AndyEveritt/FEEG2001-Eurobot/README.md

# Eurobot 2017

University of Southampton Eurobot 2017
