AndyEveritt/FEEG2001-Eurobot/CAD/Launcher/preview.JPG

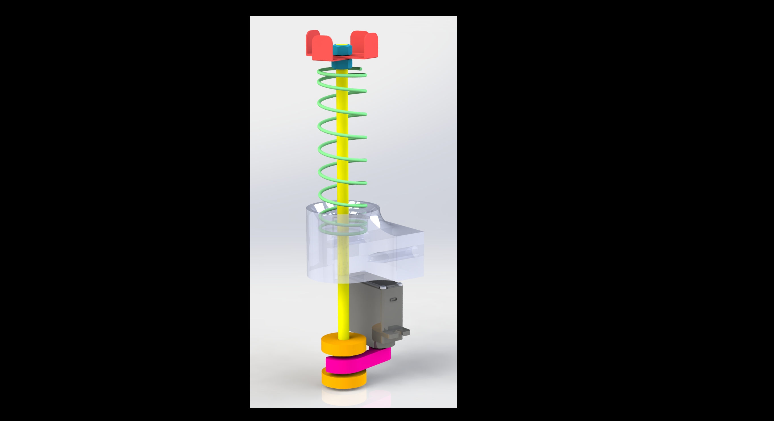
CAD/Launcher/preview.JPG
