AndyEveritt/FEEG2001-Eurobot/Code/Demonstration Route.png

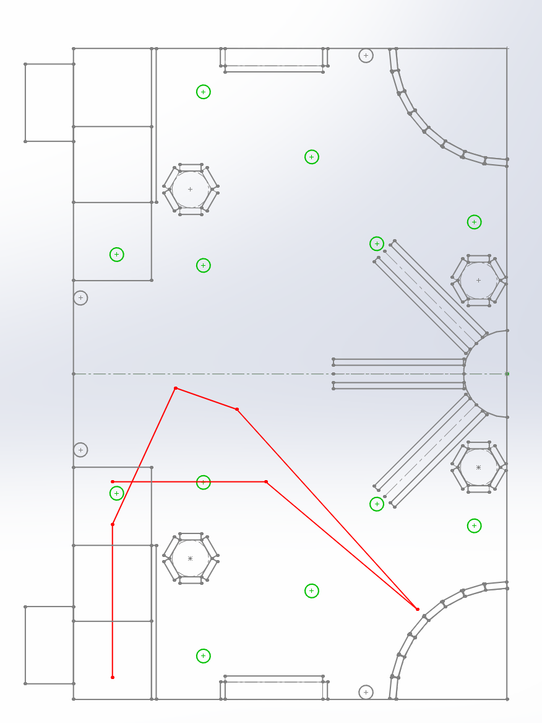
Code/Demonstration Route.png
