AndyEveritt/FEEG2001-Eurobot/Code/Screen Shot 2017-03-15 at 10.18.48.png

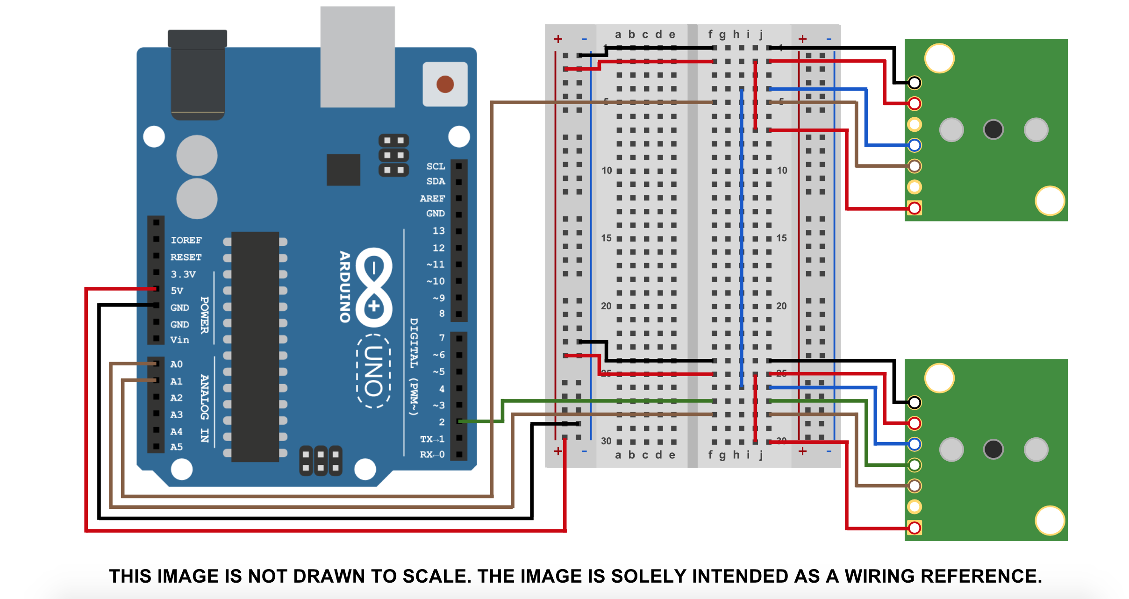
Code/Screen Shot 2017-03-15 at 10.18.48.png
