AndyEveritt/FEEG2001-Eurobot/Code/Speed Profile.png

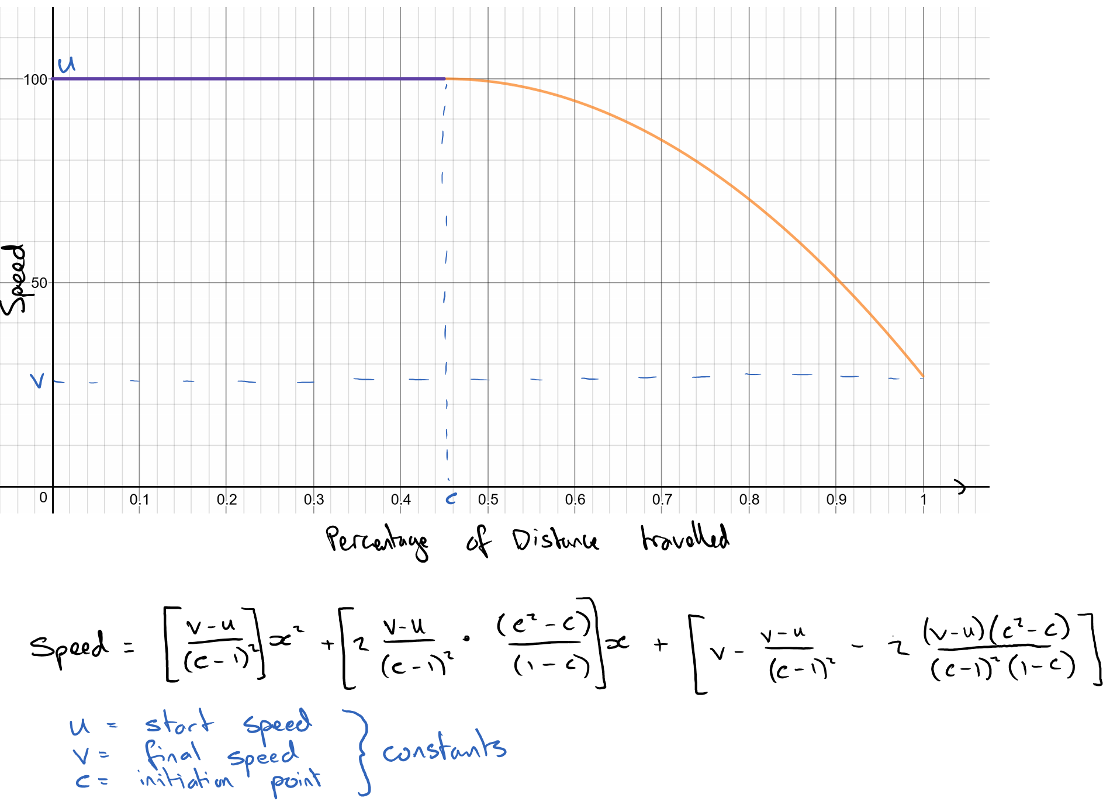
Code/Speed Profile.png
