AndyEveritt/FEEG2001-Eurobot/Concept Design Report/overallsketch2.jpeg

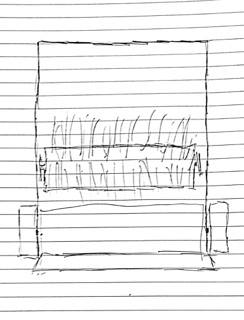
Concept Design Report/overallsketch2.jpeg
