AndyEveritt/FEEG2001-Eurobot/Concept Design Report/overallsketch 3.jpeg

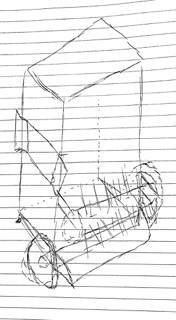
Concept Design Report/overallsketch 3.jpeg
