AndyEveritt/FEEG2001-Eurobot/CAD/RobotV2/RobotV2.SLDASM

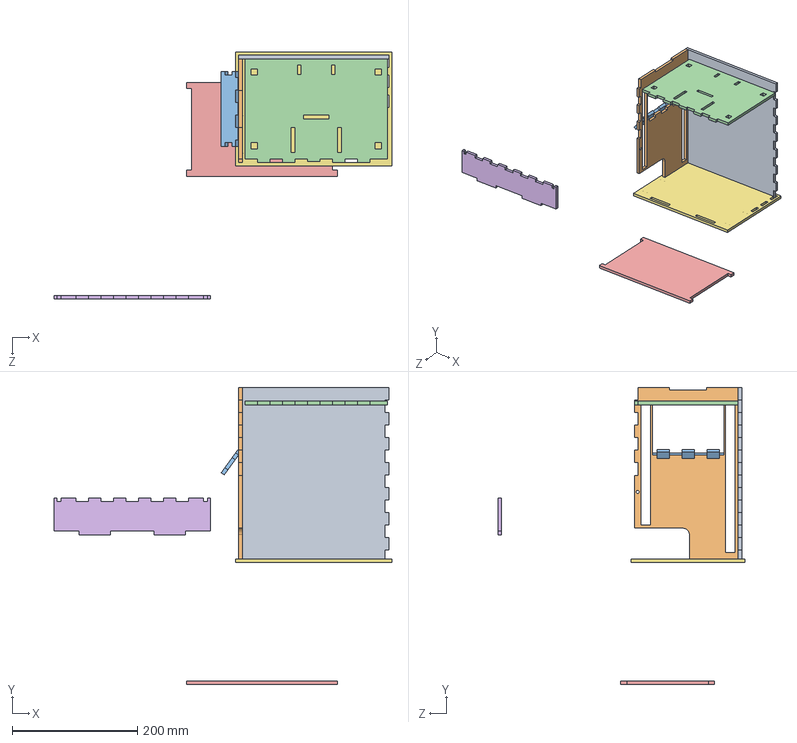
[picture p7: CAD file, 2020-12-26]
CAD/RobotV2/RobotV2.SLDASM
540.0 x 474.9 x 394.8 mm
BackV2
Lift System - Side
Lift System - Top Ramp Shortened
Lift System - TopShortened
Lift System - Tray Base Shortened
LoweredFront
Base
