AndyEveritt/FEEG2001-Eurobot/CAD/Base/BaseWheelsElliot.SLDASM

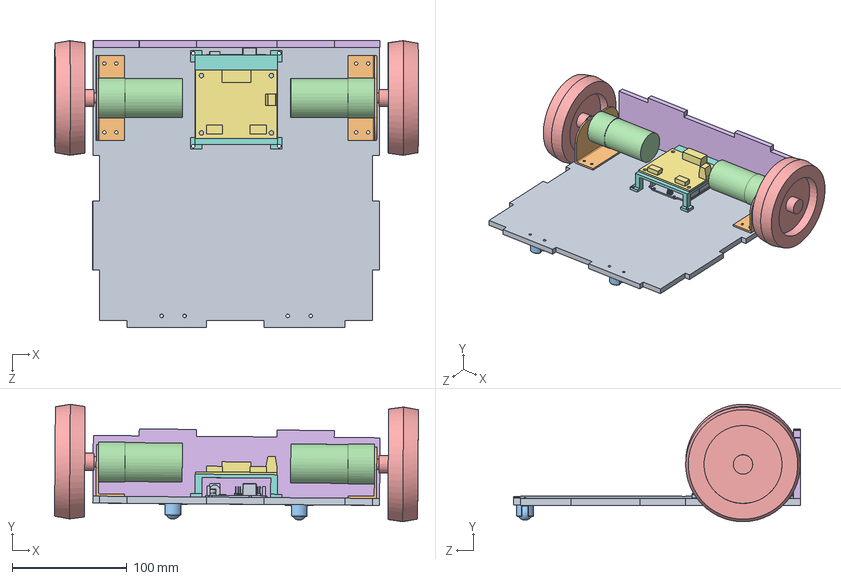
[picture p8: CAD file, 2020-12-26]
CAD/Base/BaseWheelsElliot.SLDASM
317.3 x 102.3 x 250.0 mm
Base
Motor Mount x 2
Ball Caster x 2
Motor x 2
Wheel x 2
Front
MD25
Table
Arduino UNO
