AndyEveritt/FEEG2001-Eurobot/CAD/HS-82MG Servo/HS-82MG (Micro Server).SLDASM

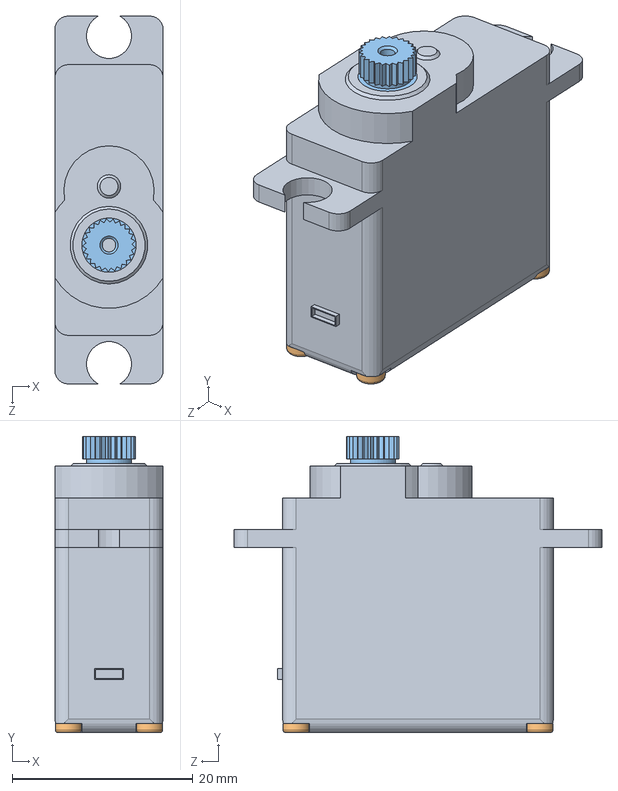
[picture p9: CAD file, 2020-12-26]
CAD/HS-82MG Servo/HS-82MG (Micro Server).SLDASM
12.0 x 32.8 x 40.8 mm
Servo Body
screw head x 4
Metal Gear
