AndyEveritt/FEEG2001-Eurobot/CAD/Launcher/Launcher.SLDASM

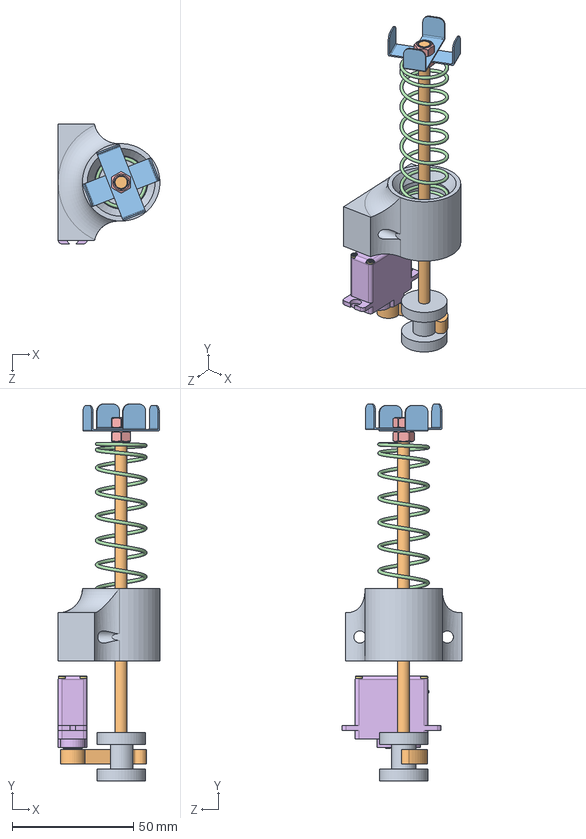
[picture p11: CAD file, 2020-12-26]
CAD/Launcher/Launcher.SLDASM
42.0 x 155.5 x 49.4 mm
Spring Holder
Rod
Holder x 2
Spring
universal_nut x 2
Servo Body
screw head x 4
Metal Gear
Latch 2
Latch 2 Hook
