AndyEveritt/FEEG2001-Eurobot/CAD/3D Printing/Spring Holder.STL

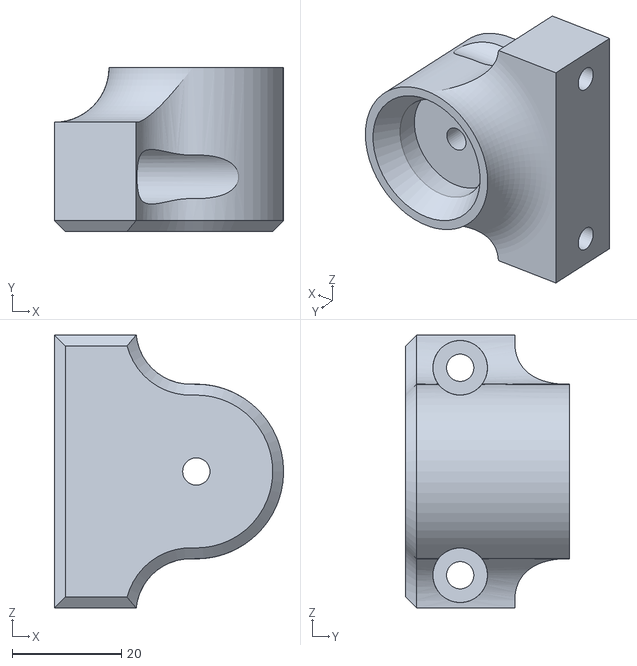
[picture p12: CAD file, 2020-12-26]
CAD/3D Printing/Spring Holder.STL
42.0 x 30.0 x 50.0
