AndyEveritt/FEEG2001-Eurobot/CAD/Base/Drawings/Front.DXF

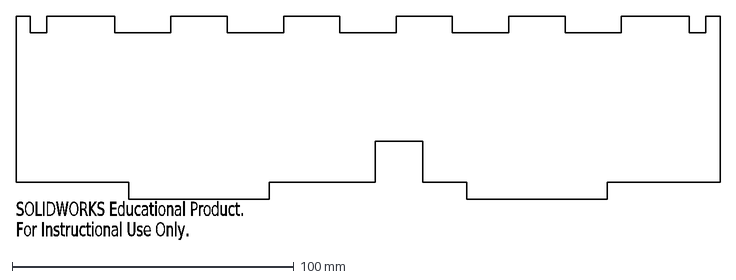
[picture p13: CAD file, 2020-12-26]
CAD/Base/Drawings/Front.DXF
SOLIDWORKS Educational Product.
For Instructional Use Only.
