AndyEveritt/FEEG2001-Eurobot/CAD/Base/Side.SLDPRT

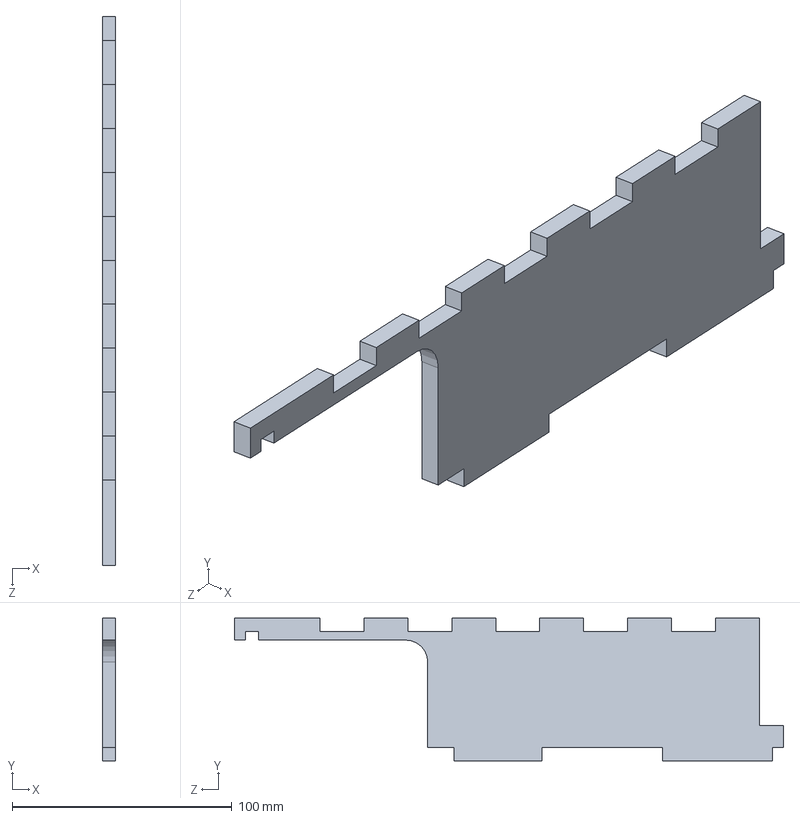
[picture p14: CAD file, 2020-12-26]
CAD/Base/Side.SLDPRT
6.00 x 65.0 x 250.0 mm
