AndyEveritt/FEEG2001-Eurobot/CAD/Existing Parts/Battery.SLDPRT

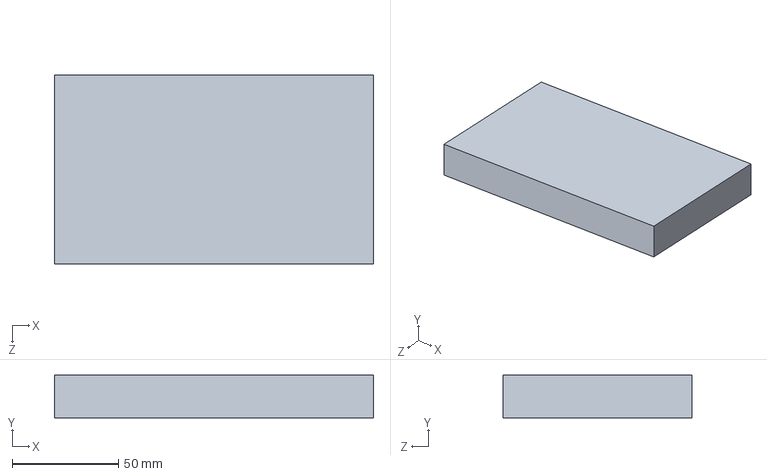
[picture p15: CAD file, 2020-12-26]
CAD/Existing Parts/Battery.SLDPRT
150.0 x 20.0 x 89.0 mm
