AndyEveritt/FEEG2001-Eurobot/CAD/PullCord.SLDPRT

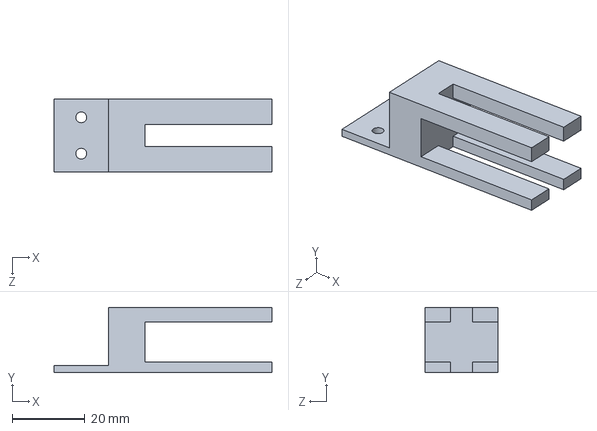
[picture p16: CAD file, 2020-12-26]
CAD/PullCord.SLDPRT
60.0 x 18.0 x 20.0 mm
