AndyEveritt/FEEG2001-Eurobot/CAD/RobotV2/Drawings/Lift System - TopShortened.DXF

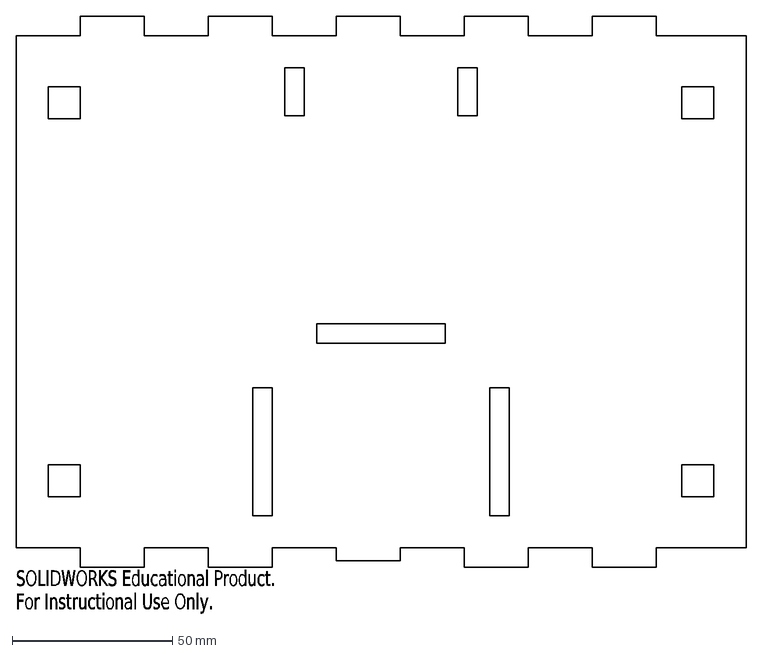
[picture p17: CAD file, 2020-12-26]
CAD/RobotV2/Drawings/Lift System - TopShortened.DXF
SOLIDWORKS Educational Product.
For Instructional Use Only.
