AndyEveritt/FEEG2001-Eurobot/CAD/3D Printing/Table.STL

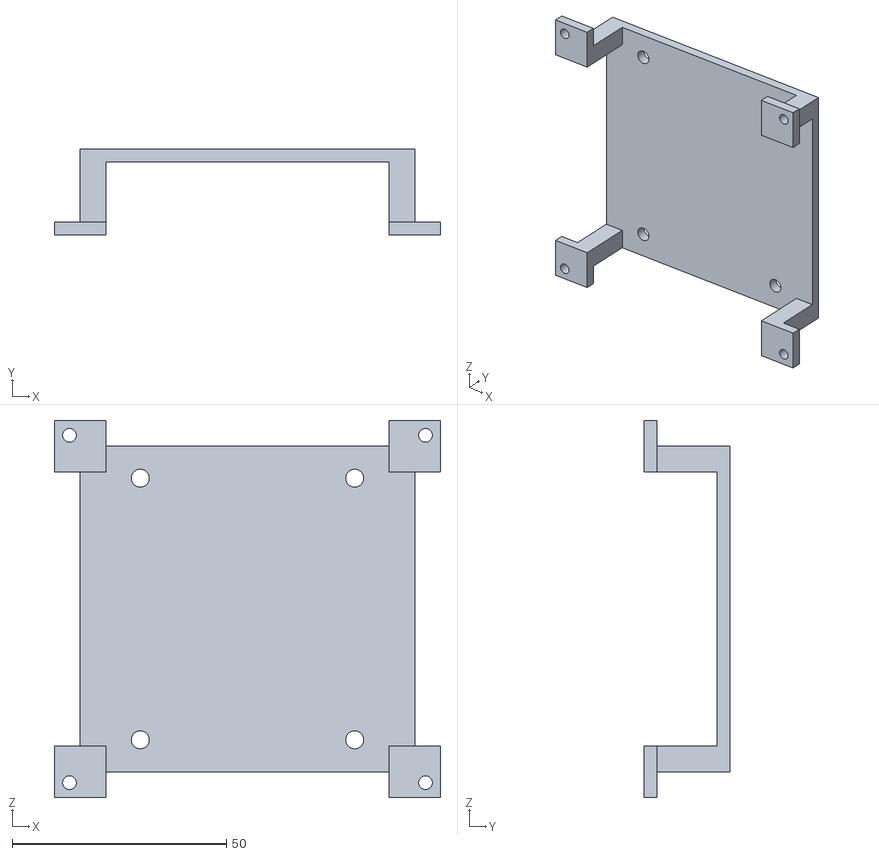
[picture p18: CAD file, 2020-12-26]
CAD/3D Printing/Table.STL
90.0 x 20.0 x 88.0
