AndyEveritt/FEEG2001-Eurobot/CAD/Base/Back.SLDPRT

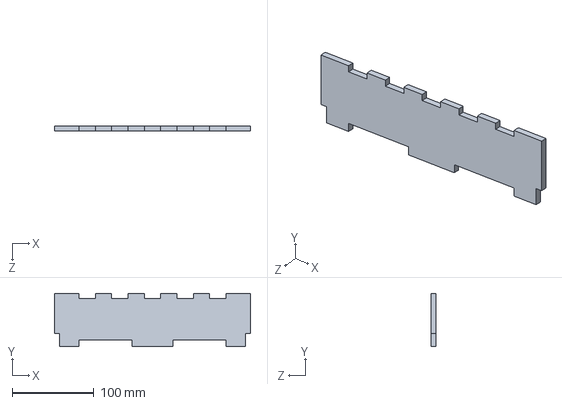
[picture p19: CAD file, 2020-12-26]
CAD/Base/Back.SLDPRT
240.0 x 65.0 x 6.00 mm
