AndyEveritt/FEEG2001-Eurobot/CAD/Base/Drawings/Back (flat).DXF

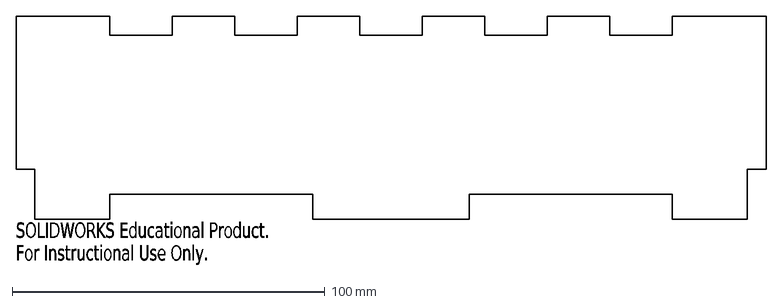
[picture p20: CAD file, 2020-12-26]
CAD/Base/Drawings/Back (flat).DXF
SOLIDWORKS Educational Product.
For Instructional Use Only.
