AndyEveritt/FEEG2001-Eurobot/CAD/Existing Parts/Motor.SLDPRT

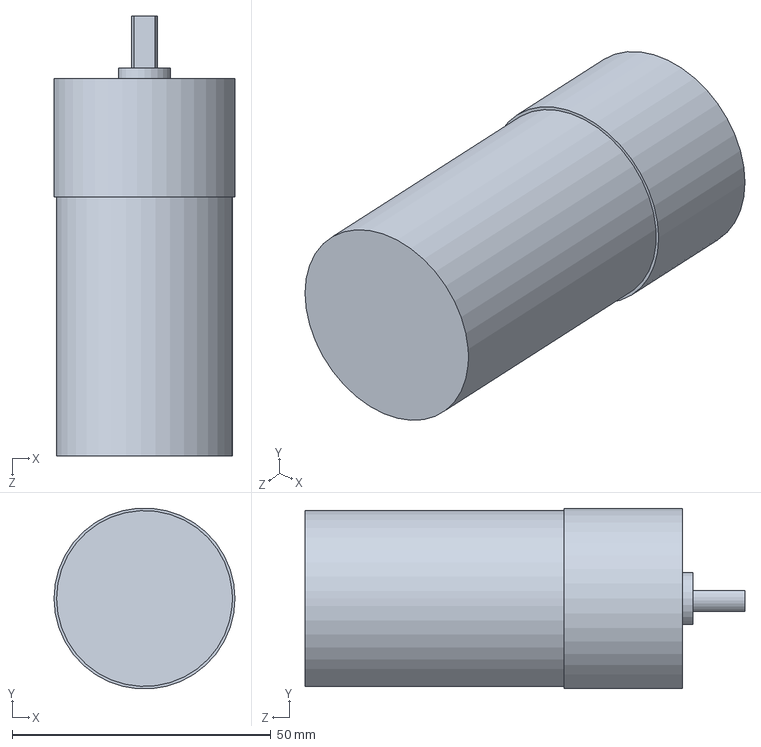
[picture p21: CAD file, 2020-12-26]
CAD/Existing Parts/Motor.SLDPRT
35.0 x 34.9 x 85.0 mm
