AndyEveritt/FEEG2001-Eurobot/CAD/HS-82MG Servo/Servo Body.SLDPRT

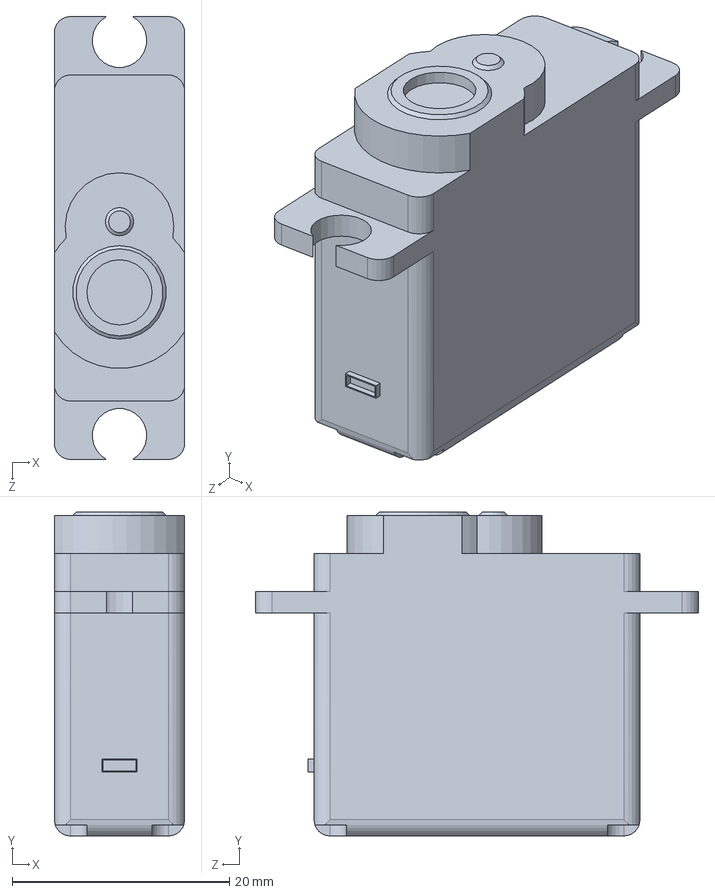
[picture p22: CAD file, 2020-12-26]
CAD/HS-82MG Servo/Servo Body.SLDPRT
12.0 x 29.8 x 40.8 mm
