AndyEveritt/FEEG2001-Eurobot/CAD/Launcher/Holder.SLDPRT

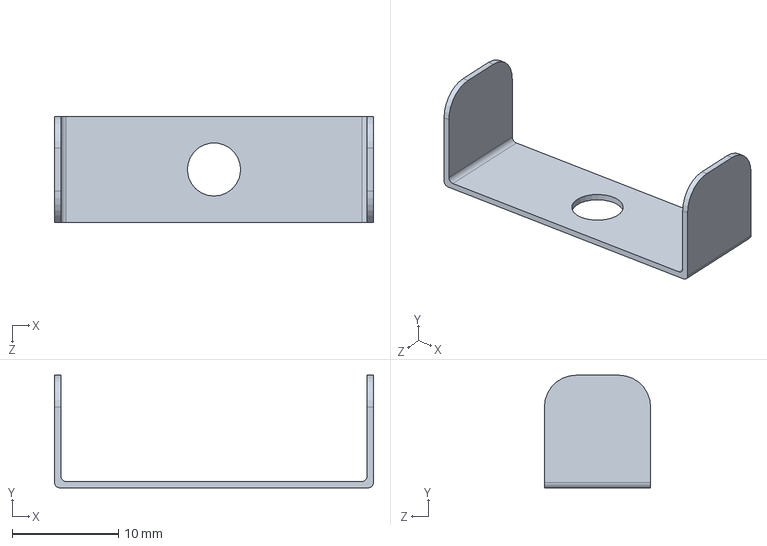
[picture p23: CAD file, 2020-12-26]
CAD/Launcher/Holder.SLDPRT
30.0 x 10.6 x 10.0 mm
