AndyEveritt/FEEG2001-Eurobot/CAD/RobotV2/Drawings/LoweredFront.DXF

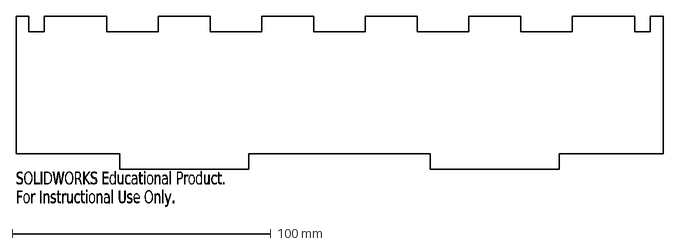
[picture p24: CAD file, 2020-12-26]
CAD/RobotV2/Drawings/LoweredFront.DXF
SOLIDWORKS Educational Product.
For Instructional Use Only.
