AndyEveritt/FEEG2001-Eurobot/CAD/RobotV2/Lift System - Tray Base Shortened.SLDPRT

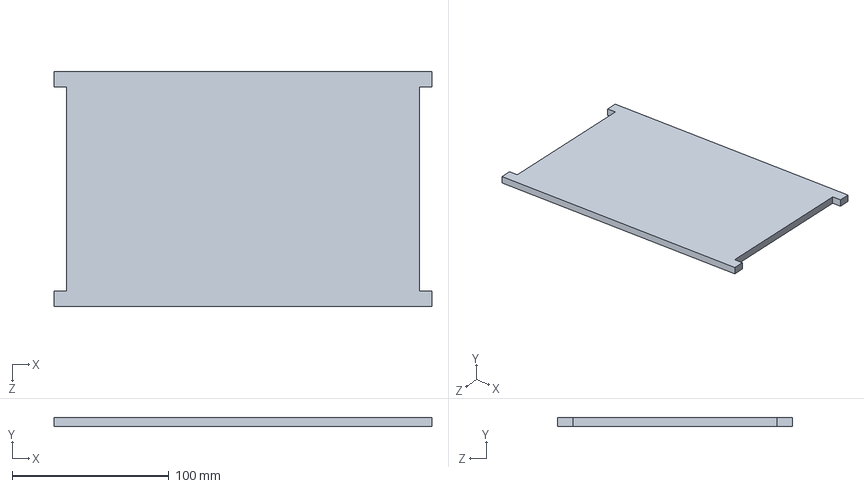
[picture p25: CAD file, 2020-12-26]
CAD/RobotV2/Lift System - Tray Base Shortened.SLDPRT
241.0 x 6.00 x 150.0 mm
