AndyEveritt/FEEG2001-Eurobot/CAD/Base/Drawings/Side (flat).DXF

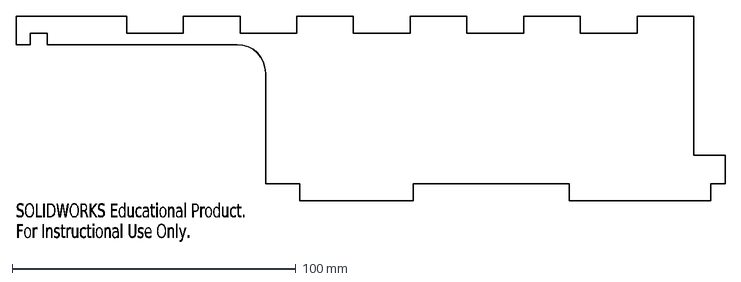
[picture p26: CAD file, 2020-12-26]
CAD/Base/Drawings/Side (flat).DXF
SOLIDWORKS Educational Product.
For Instructional Use Only.
