AndyEveritt/FEEG2001-Eurobot/CAD/Existing Parts/Wheel.SLDPRT

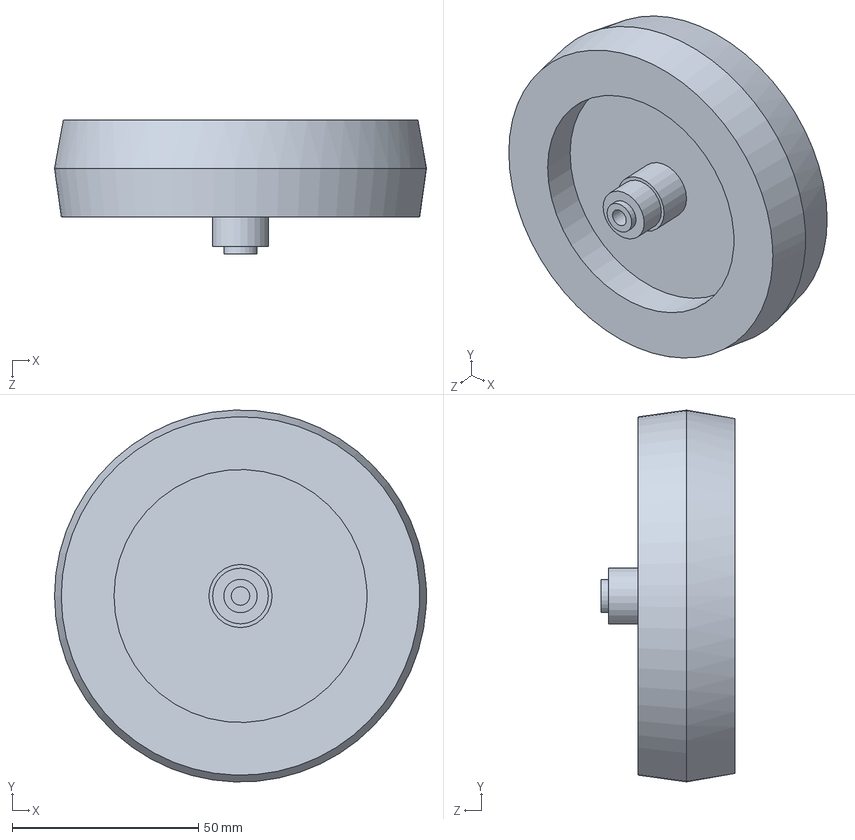
[picture p27: CAD file, 2020-12-26]
CAD/Existing Parts/Wheel.SLDPRT
100.0 x 100.0 x 36.0 mm
