AndyEveritt/FEEG2001-Eurobot/CAD/Launcher/Latch.SLDPRT

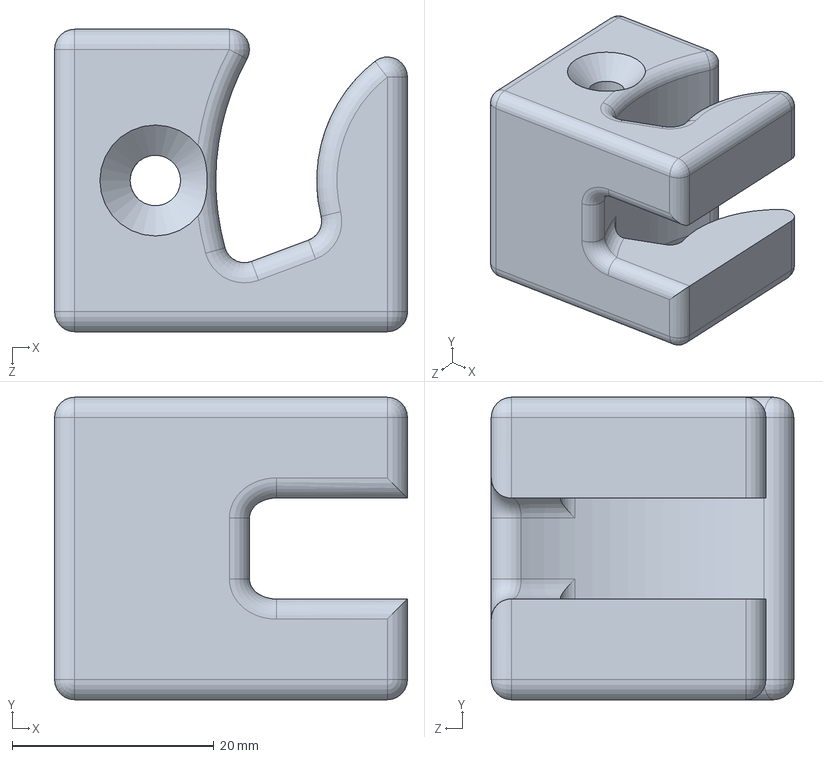
[picture p28: CAD file, 2020-12-26]
CAD/Launcher/Latch.SLDPRT
35.0 x 30.0 x 30.0 mm
