AndyEveritt/FEEG2001-Eurobot/CAD/RobotV2/Drawings/Base.DXF

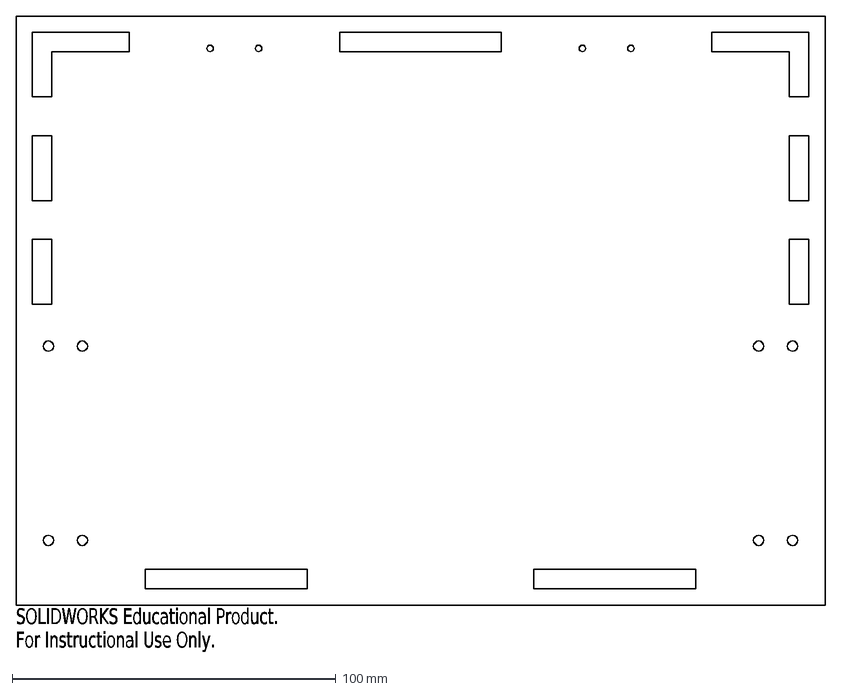
[picture p29: CAD file, 2020-12-26]
CAD/RobotV2/Drawings/Base.DXF
SOLIDWORKS Educational Product.
For Instructional Use Only.
