AndyEveritt/FEEG2001-Eurobot/CAD/RobotV2/Lift System - Top Ramp Shortened.SLDPRT

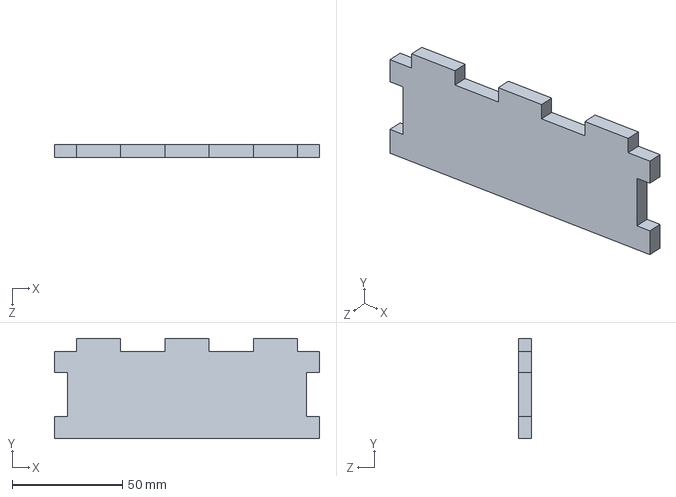
[picture p30: CAD file, 2020-12-26]
CAD/RobotV2/Lift System - Top Ramp Shortened.SLDPRT
120.0 x 45.3 x 6.00 mm
