AndyEveritt/FEEG2001-Eurobot/CAD/Base/Base.SLDPRT

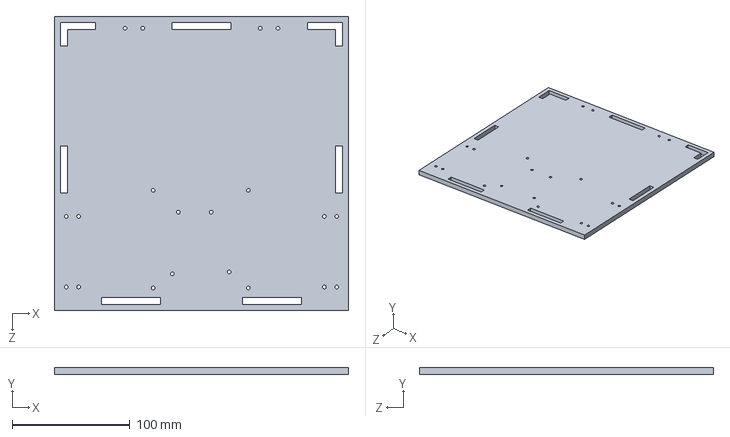
[picture p31: CAD file, 2020-12-26]
CAD/Base/Base.SLDPRT
250.0 x 6.00 x 250.0 mm
