AndyEveritt/FEEG2001-Eurobot/CAD/Base/Drawings/Back.DXF

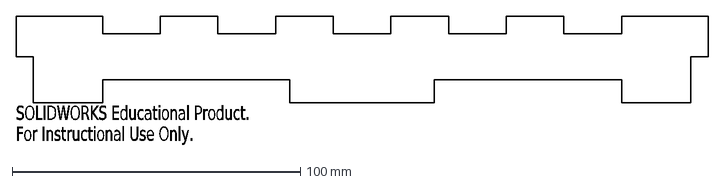
[picture p32: CAD file, 2020-12-26]
CAD/Base/Drawings/Back.DXF
SOLIDWORKS Educational Product.
For Instructional Use Only.
