AndyEveritt/FEEG2001-Eurobot/CAD/Existing Parts/Motor Mount.SLDPRT

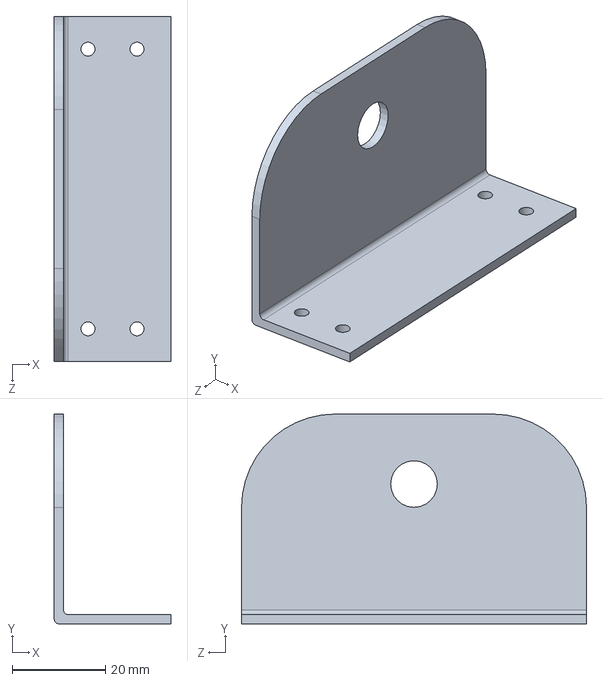
[picture p33: CAD file, 2020-12-26]
CAD/Existing Parts/Motor Mount.SLDPRT
25.0 x 45.0 x 74.0 mm
