AndyEveritt/FEEG2001-Eurobot/CAD/HS-82MG Servo/Metal Gear.SLDPRT

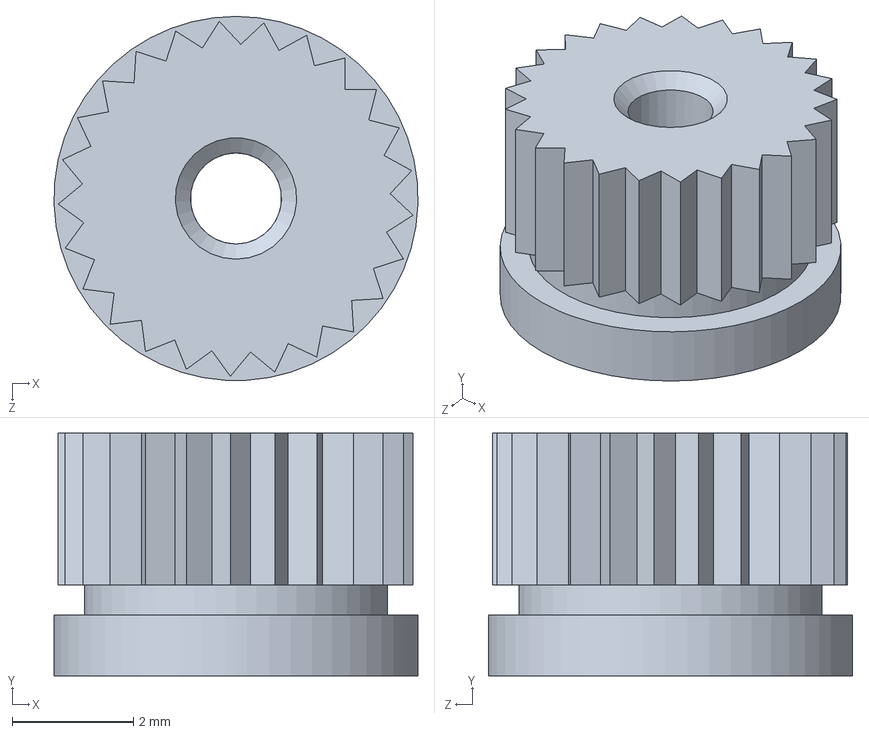
[picture p34: CAD file, 2020-12-26]
CAD/HS-82MG Servo/Metal Gear.SLDPRT
6.00 x 4.00 x 6.00 mm
