AndyEveritt/FEEG2001-Eurobot/CAD/Launcher/Latch 2 Hook.SLDPRT

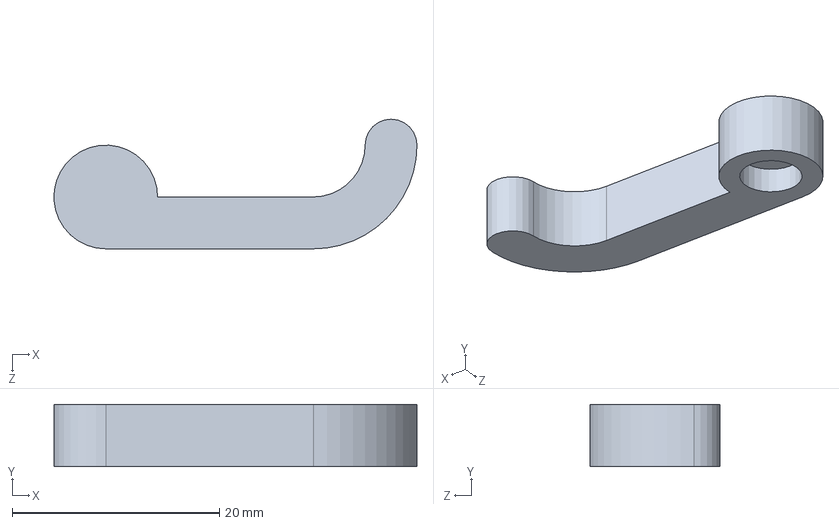
[picture p35: CAD file, 2020-12-26]
CAD/Launcher/Latch 2 Hook.SLDPRT
35.0 x 6.00 x 12.5 mm
