AndyEveritt/FEEG2001-Eurobot/CAD/RobotV2/Base.SLDPRT

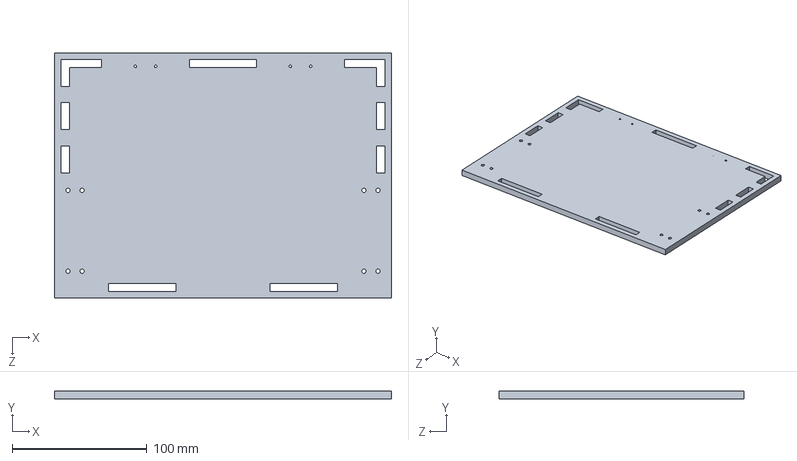
[picture p36: CAD file, 2020-12-26]
CAD/RobotV2/Base.SLDPRT
250.0 x 6.00 x 182.0 mm
