AndyEveritt/FEEG2001-Eurobot/CAD/RobotV2/Drawings/BackV2.DXF

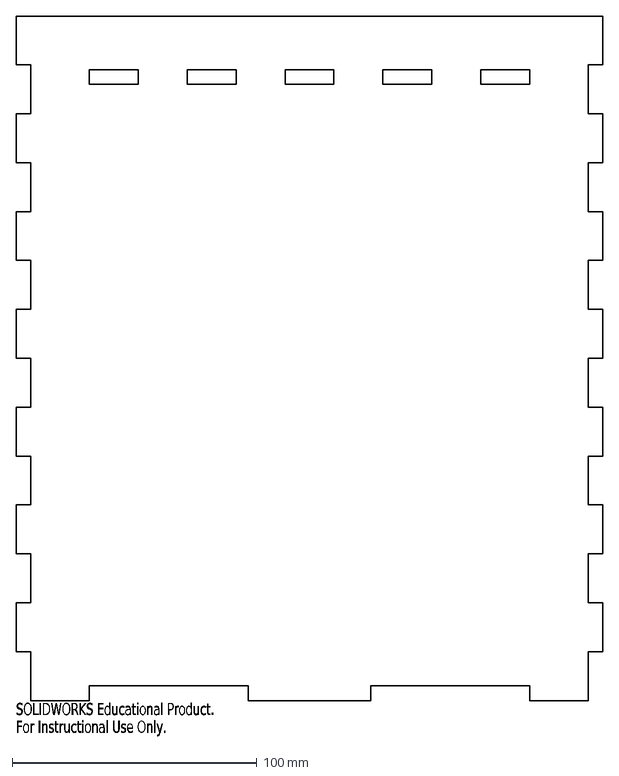
[picture p37: CAD file, 2020-12-26]
CAD/RobotV2/Drawings/BackV2.DXF
SOLIDWORKS Educational Product.
For Instructional Use Only.
