AndyEveritt/FEEG2001-Eurobot/CAD/Base/Arduino UNO.SLDPRT

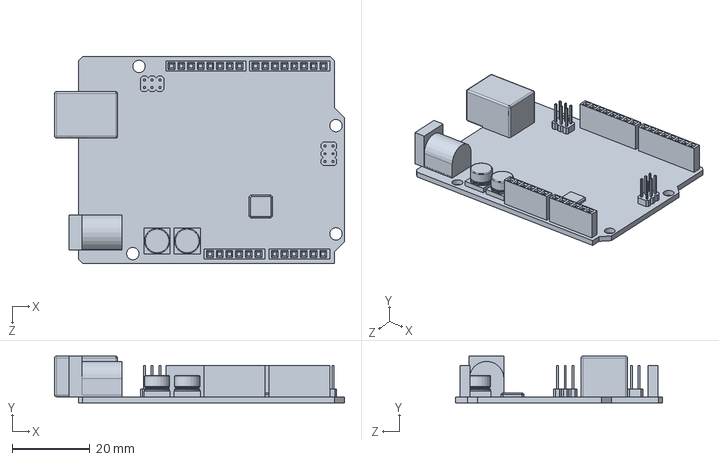
[picture p38: CAD file, 2020-12-26]
CAD/Base/Arduino UNO.SLDPRT
74.8 x 12.1 x 53.3 mm
