AndyEveritt/FEEG2001-Eurobot/CAD/Base/Drawings/Side.DXF

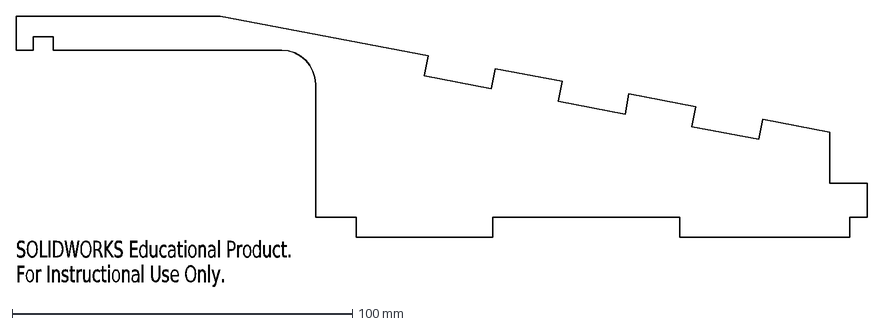
[picture p39: CAD file, 2020-12-26]
CAD/Base/Drawings/Side.DXF
SOLIDWORKS Educational Product.
For Instructional Use Only.
