AndyEveritt/FEEG2001-Eurobot/CAD/Existing Parts/MD25.SLDPRT

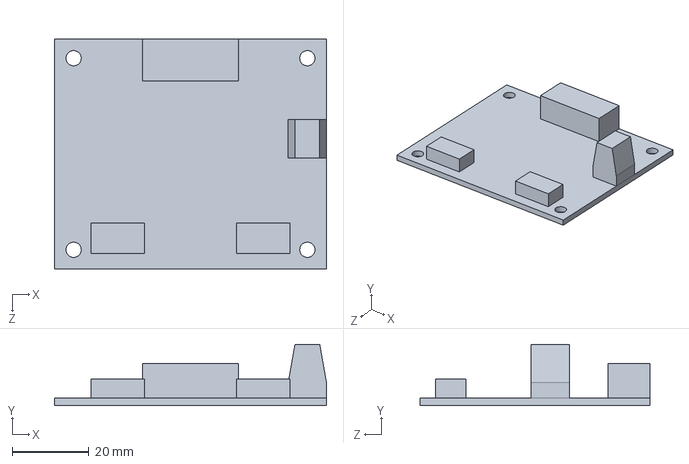
[picture p40: CAD file, 2020-12-26]
CAD/Existing Parts/MD25.SLDPRT
71.0 x 16.0 x 60.0 mm
