AndyEveritt/FEEG2001-Eurobot/CAD/Launcher/Spring Holder.SLDPRT

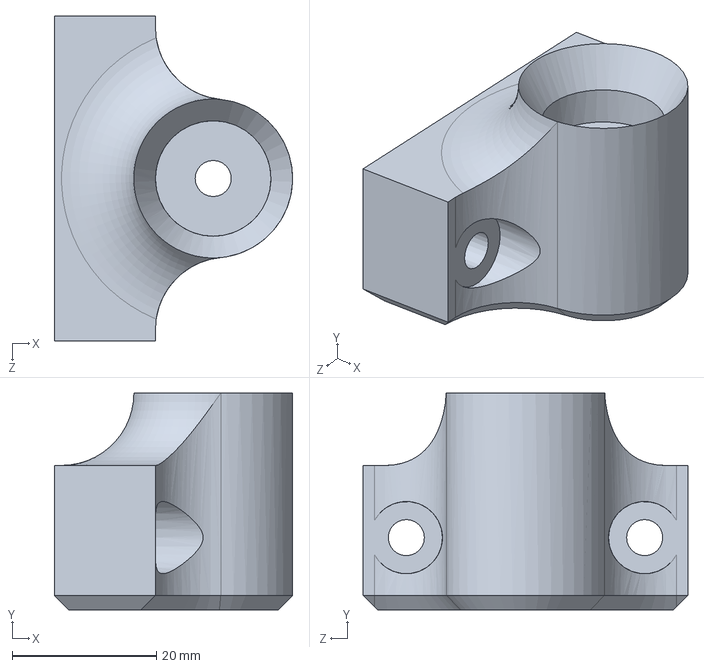
[picture p41: CAD file, 2020-12-26]
CAD/Launcher/Spring Holder.SLDPRT
33.0 x 30.0 x 45.0 mm
