AndyEveritt/FEEG2001-Eurobot/CAD/RobotV2/Drawings/Lift System - Side.DXF

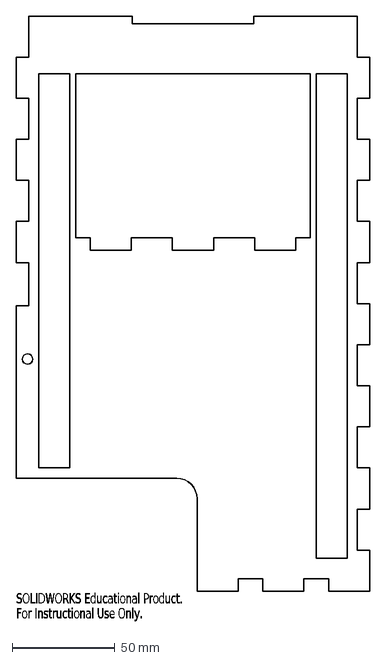
[picture p42: CAD file, 2020-12-26]
CAD/RobotV2/Drawings/Lift System - Side.DXF
SOLIDWORKS Educational Product.
For Instructional Use Only.
