AndyEveritt/FEEG2001-Eurobot/CAD/RobotV2/Lift System - TopShortened.SLDPRT

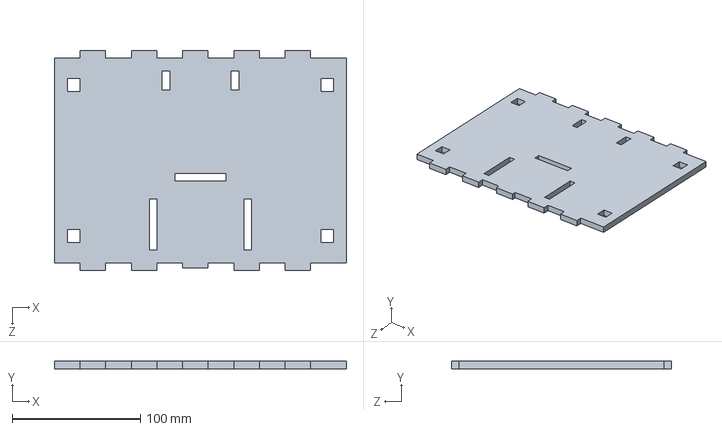
[picture p43: CAD file, 2020-12-26]
CAD/RobotV2/Lift System - TopShortened.SLDPRT
228.0 x 6.00 x 172.0 mm
