AndyEveritt/FEEG2001-Eurobot/CAD/Base/Drawings/Base.DXF

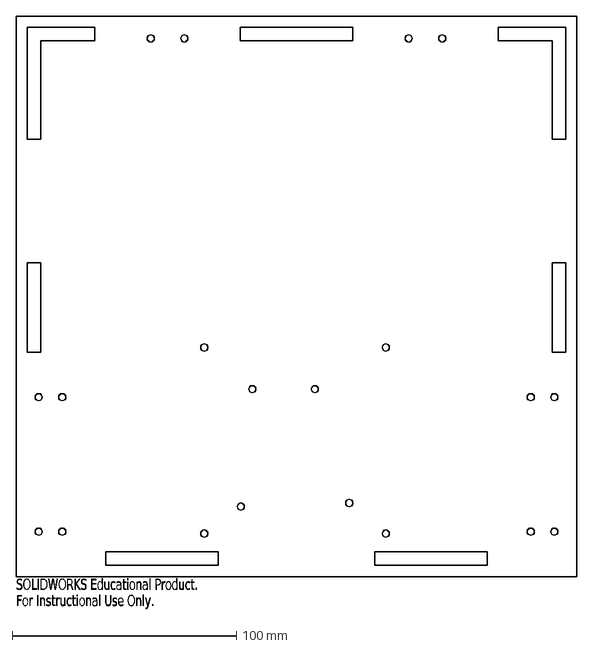
[picture p44: CAD file, 2020-12-26]
CAD/Base/Drawings/Base.DXF
SOLIDWORKS Educational Product.
For Instructional Use Only.
