AndyEveritt/FEEG2001-Eurobot/CAD/Existing Parts/Arduino.SLDPRT

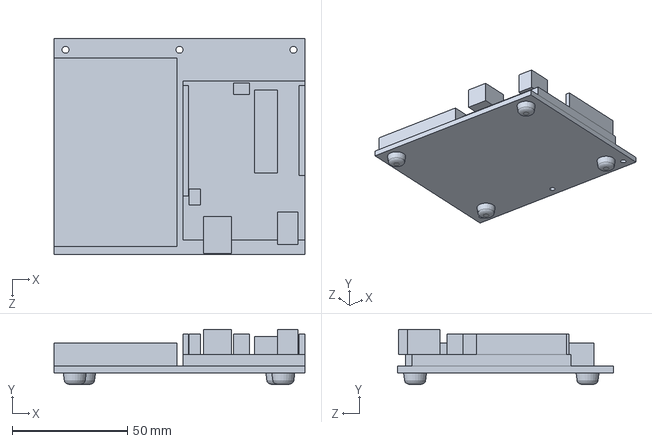
[picture p45: CAD file, 2020-12-26]
CAD/Existing Parts/Arduino.SLDPRT
109.0 x 24.0 x 94.0 mm
