AndyEveritt/FEEG2001-Eurobot/CAD/Launcher/Latch 2.SLDPRT

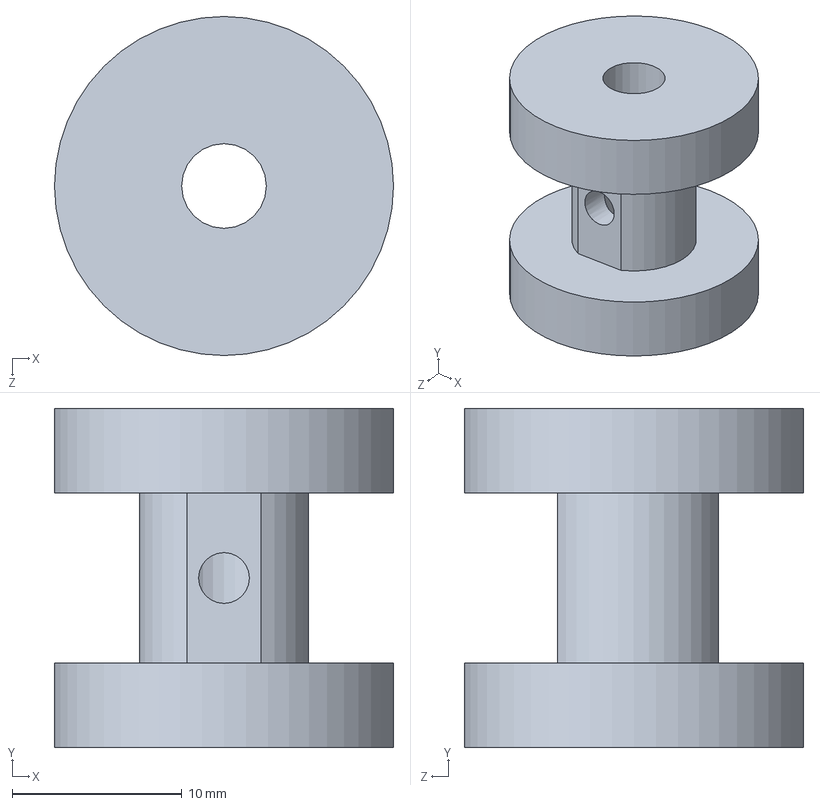
[picture p46: CAD file, 2020-12-26]
CAD/Launcher/Latch 2.SLDPRT
20.0 x 20.0 x 20.0 mm
