AndyEveritt/FEEG2001-Eurobot/CAD/RobotV2/BackV2.SLDPRT

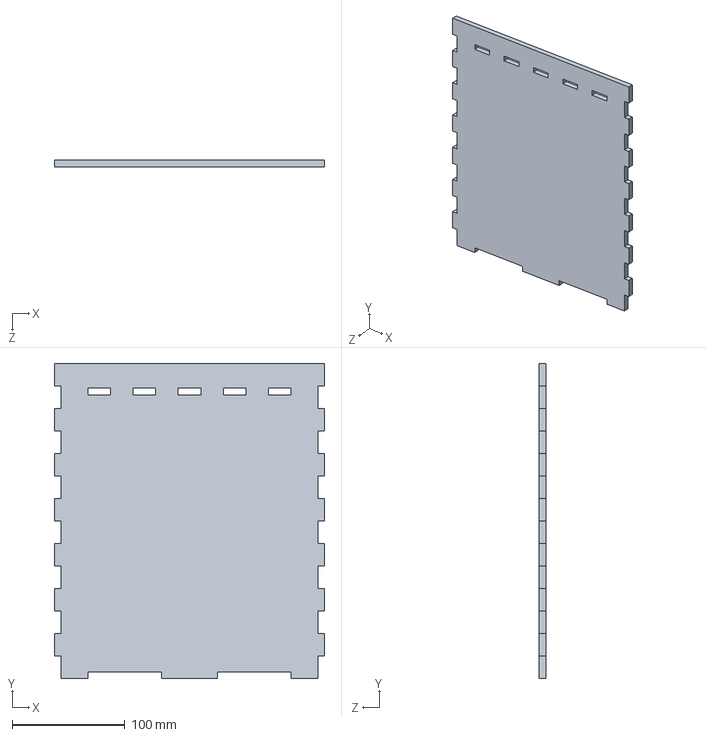
[picture p47: CAD file, 2020-12-26]
CAD/RobotV2/BackV2.SLDPRT
240.0 x 280.0 x 6.00 mm
