AndyEveritt/FEEG2001-Eurobot/CAD/RobotV2/Drawings/Lift System - Top Ramp Shortened.DXF

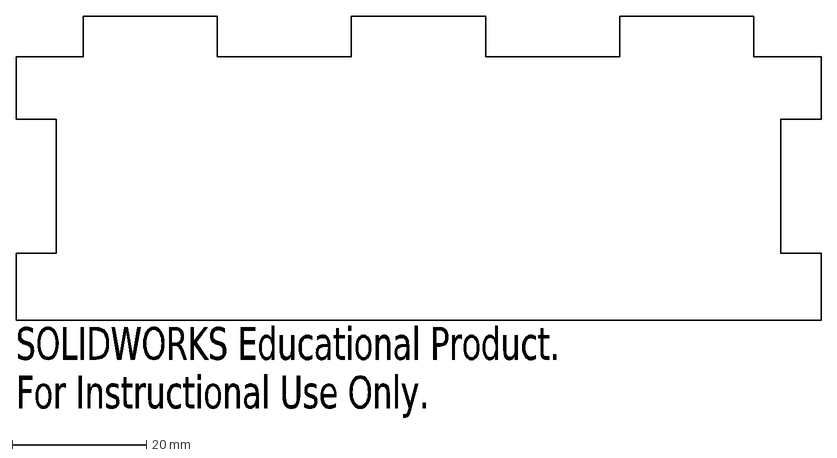
[picture p48: CAD file, 2020-12-26]
CAD/RobotV2/Drawings/Lift System - Top Ramp Shortened.DXF
SOLIDWORKS Educational Product.
For Instructional Use Only.
