AndyEveritt/FEEG2001-Eurobot/CAD/Base/Button.SLDPRT

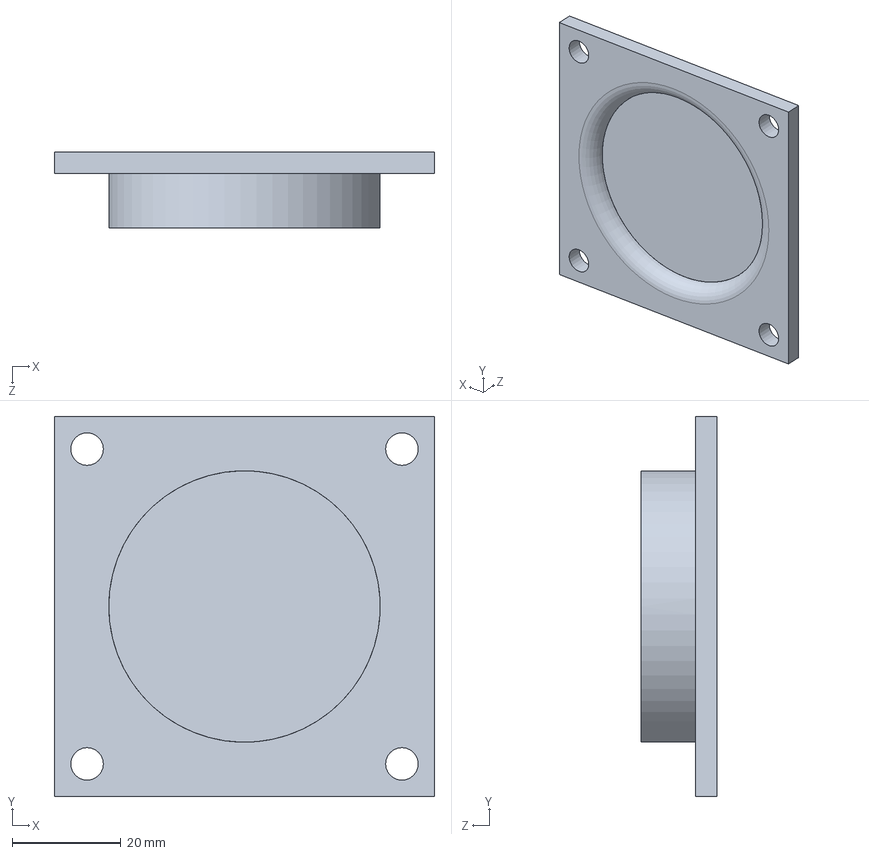
[picture p49: CAD file, 2020-12-26]
CAD/Base/Button.SLDPRT
70.0 x 70.0 x 14.0 mm
