AndyEveritt/FEEG2001-Eurobot/CAD/Existing Parts/Ball Caster.SLDPRT

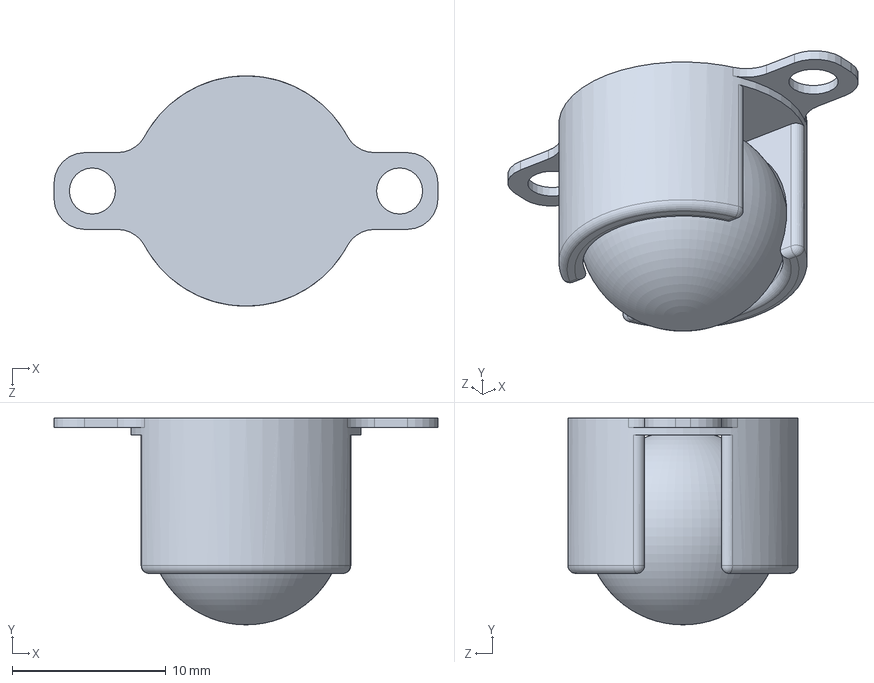
[picture p50: CAD file, 2020-12-26]
CAD/Existing Parts/Ball Caster.SLDPRT
25.0 x 13.5 x 15.0 mm
