AndyEveritt/FEEG2001-Eurobot/CAD/Launcher/Spring.SLDPRT

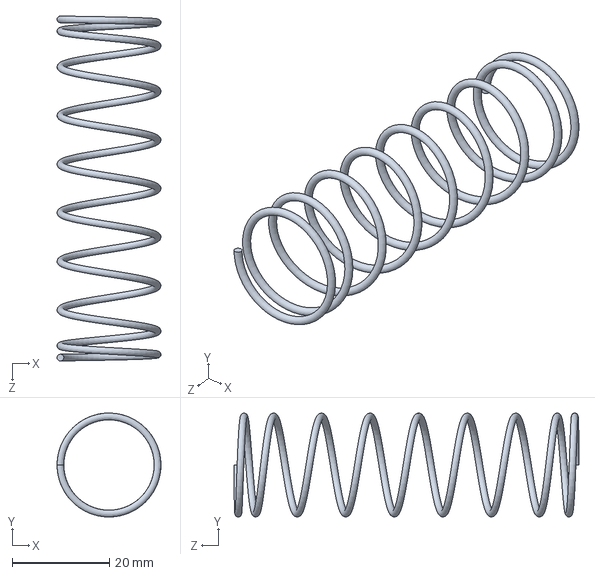
[picture p51: CAD file, 2020-12-26]
CAD/Launcher/Spring.SLDPRT
21.4 x 21.4 x 71.0 mm
