AndyEveritt/FEEG2001-Eurobot/CAD/RobotV2/Drawings/Lift System - Tray Base Shortened.DXF

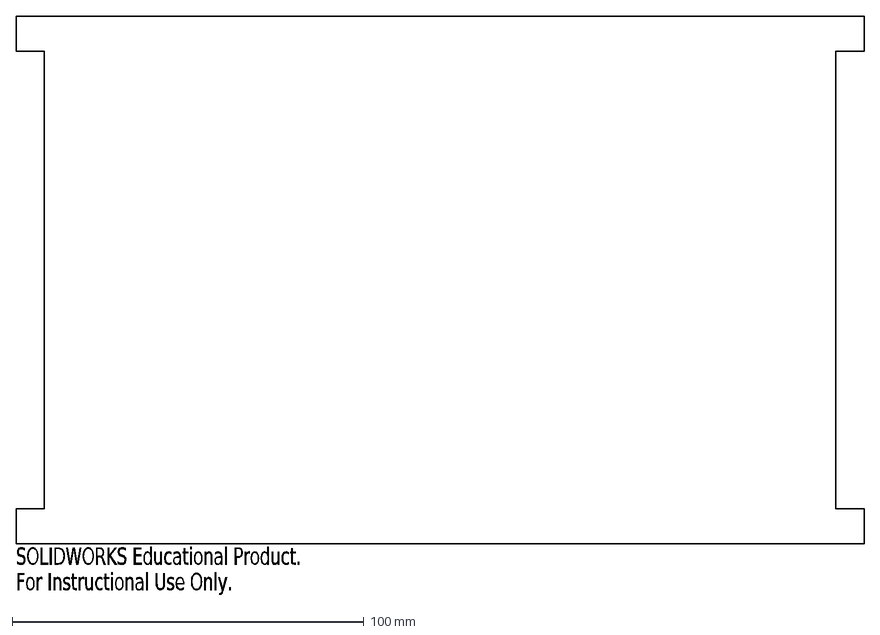
[picture p52: CAD file, 2020-12-26]
CAD/RobotV2/Drawings/Lift System - Tray Base Shortened.DXF
SOLIDWORKS Educational Product.
For Instructional Use Only.
