AndyEveritt/FEEG2001-Eurobot/CAD/RobotV2/LoweredFront.SLDPRT

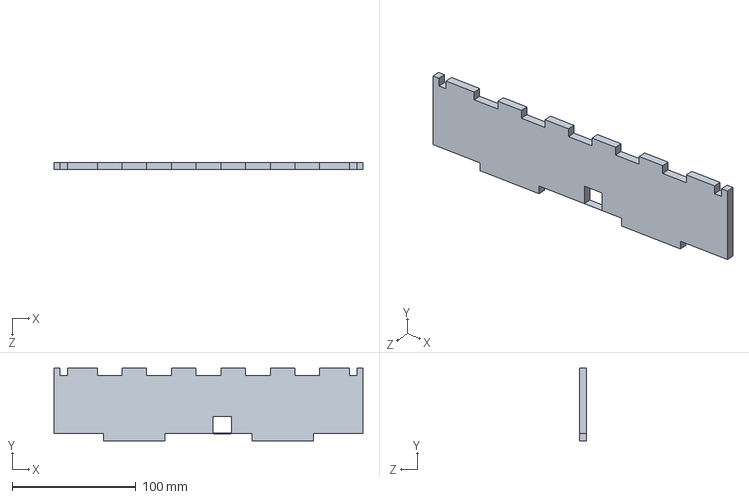
[picture p53: CAD file, 2020-12-26]
CAD/RobotV2/LoweredFront.SLDPRT
250.0 x 59.0 x 6.00 mm
