AndyEveritt/FEEG2001-Eurobot/CAD/Existing Parts/Servo.SLDPRT

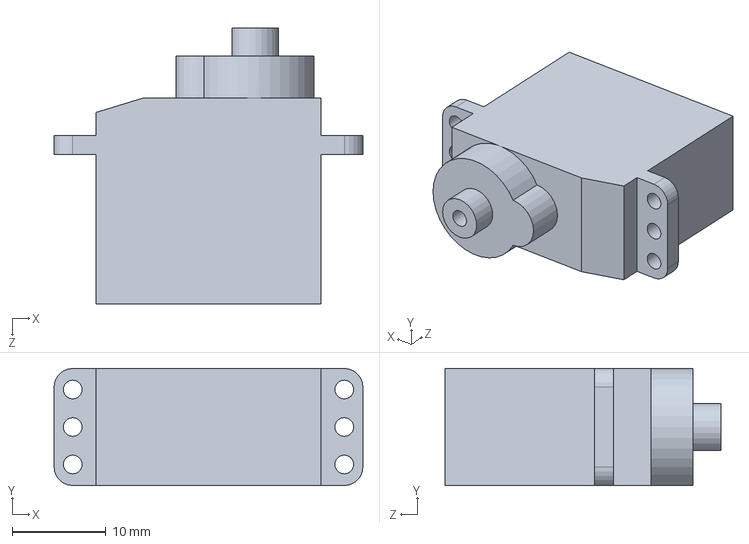
[picture p54: CAD file, 2020-12-26]
CAD/Existing Parts/Servo.SLDPRT
33.0 x 12.5 x 29.5 mm
