AndyEveritt/FEEG2001-Eurobot/CAD/RobotV2/Lift System - Side.SLDPRT

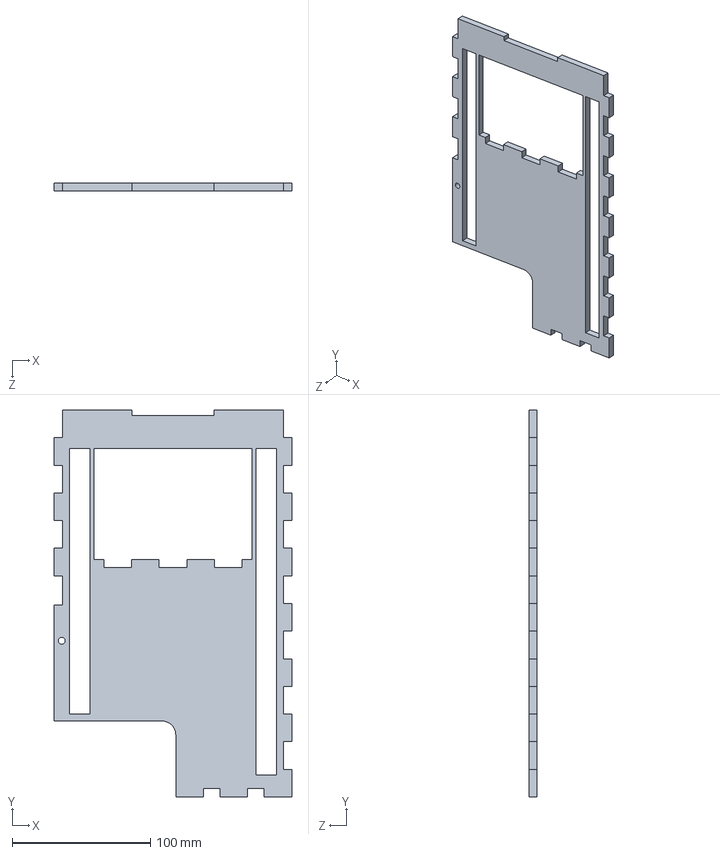
[picture p55: CAD file, 2020-12-26]
CAD/RobotV2/Lift System - Side.SLDPRT
172.0 x 280.0 x 6.00 mm
