AndyEveritt/FEEG2001-Eurobot/CAD/Base/Front.SLDPRT

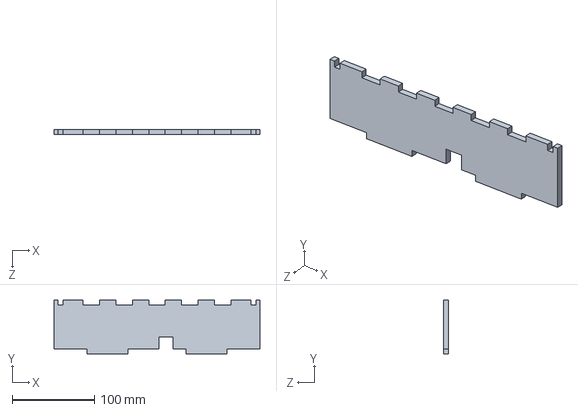
[picture p56: CAD file, 2020-12-26]
CAD/Base/Front.SLDPRT
250.0 x 65.0 x 6.00 mm
