AndyEveritt/FEEG2001-Eurobot/CAD/Launcher/Rod.SLDPRT

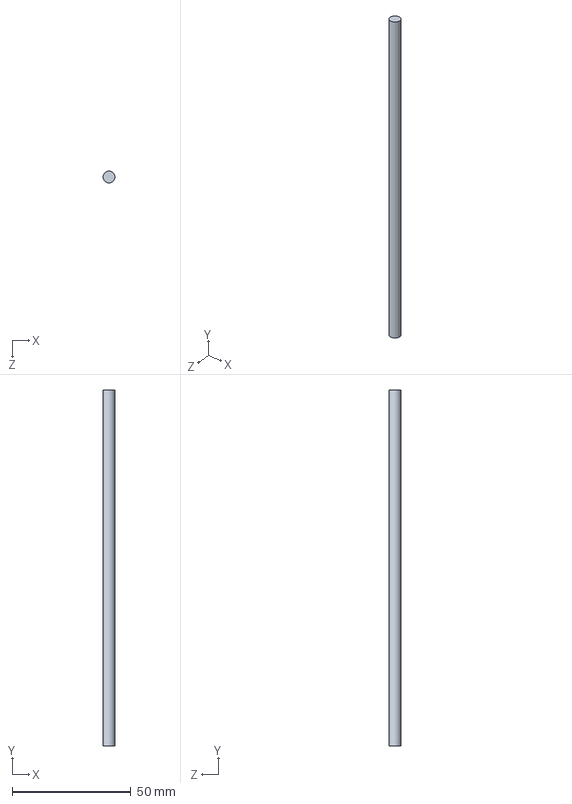
[picture p57: CAD file, 2020-12-26]
CAD/Launcher/Rod.SLDPRT
5.00 x 150.0 x 5.00 mm
