AndyEveritt/FEEG2001-Eurobot/(list of files, cad)

Other CAD files:
CAD/Drawings/Map.SLDPRT
CAD/Base/Table.SLDPRT
CAD/Drawings/Assembly Drawing.SLDDRW
CAD/Drawings/Spring Holder.SLDDRW
CAD/HS-82MG Servo/screw head.SLDPRT
CAD/Launcher/universal_nut.SLDPRT
