AndyEveritt/FEEG2001-Eurobot/Concept Design Report/Rocket Launcher.pdf

# Rocket Launcher

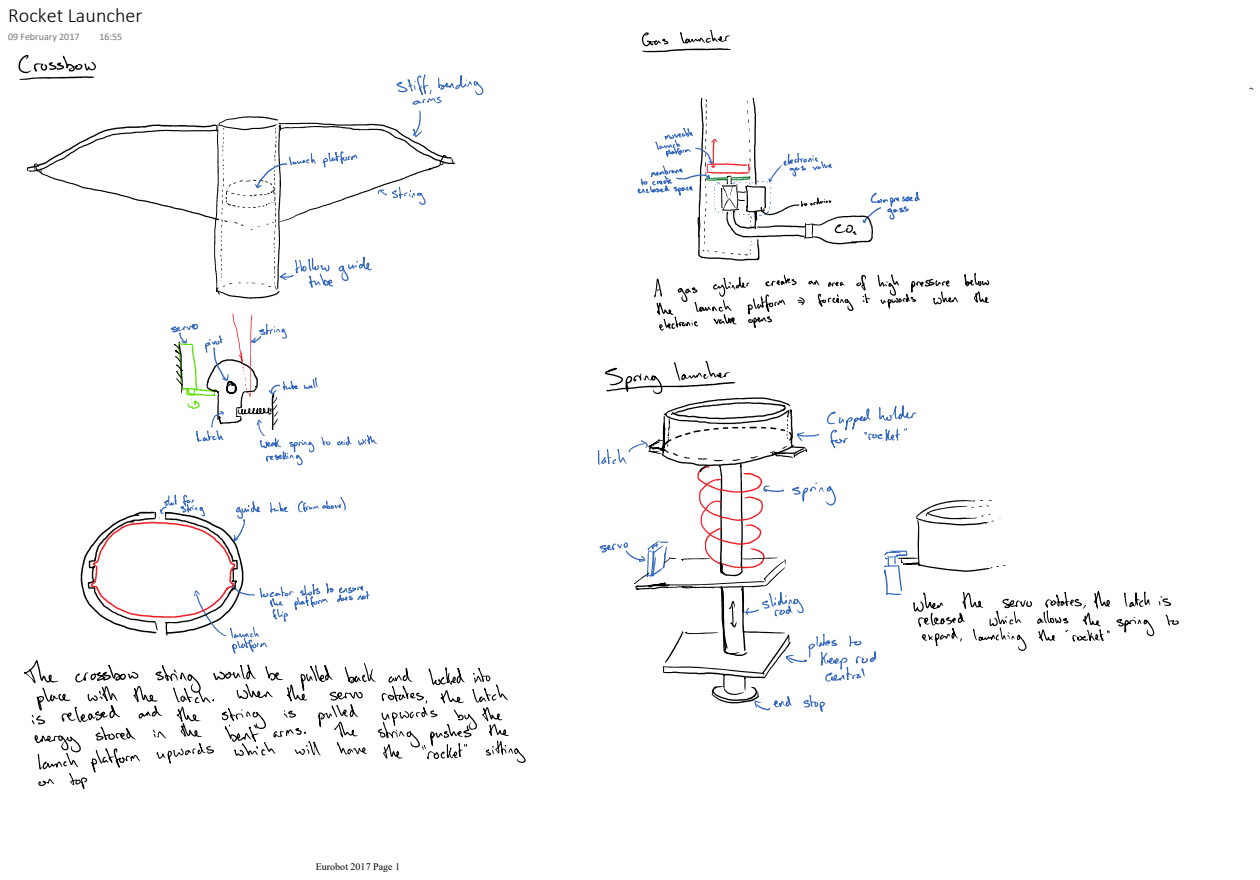
[picture p58: page 1]
09 February 2017; Eurobot 2017 Page 1
