AndyEveritt/FEEG2001-Eurobot/Code/Basic_Movement/Basic_Movement.ino

/*
2016 Odometry Task

Code written by Andrew Everitt and Ryan Firth
*/

#include <Wire.h>                                             // Calls for I2C bus library
#include <Servo.h>                                            // calls for the servo library

#define MD25ADDRESS         0x58                              // Address of the MD25
#define SPEED1              0x00                              // Byte to send speed to both motors for forward and backwards motion if operated in MODE 2 or 3 and Motor 1 Speed if in MODE 0 or 1
#define SPEED2              0x01                              // Byte to send speed for turn speed if operated in MODE 2 or 3 and Motor 2 Speed if in MODE 0 or 1
#define ENCODERONE          0x02                              // Byte to read motor encoder 1
#define ENCODERTWO          0x06                              // Byte to read motor encoder 2
#define ACCELERATION        0xE                               // Byte to define motor acceleration
#define CMD                 0x10                              // Byte to reset encoder values
#define MODE_SELECTOR       0xF                               // Byte to change between control MODES

// Inputs/Outputs
int LEDPin = 3;                                               // Sets output pin for LED
int buttonPin = 10;                                           // sets the input pin for the start button
Servo myservo;                                                // create servo object to control a servo

// Chasis Parameters & Constants
float WheelBaseDiameter = 20.5;                               // sets the distance between the wheels in cm
float WheelDiameter = 10.25;                                  // sets the diameter of the wheel
const float pi = 3.14159265359;                               // constant variable roughly equal to pi

// Movement variables
int Mode = 3;                                                 // MODE in which the MD25 will operate selector value
int S = 80;                                                   // General movement speed
float FinalSpeed = 30;                                          // End movement speed
int DefaultAcceleration = 3;                                    // Sets default acceleration value
float TurnMulti = 50.0/S;                                          // Turn speed multiplier, turn speed for each wheel = +-A*s
float ArcMulti = 2;                                           // speed multiplier for arc turns
float limit = 0.3;                                            // sets the minimum error the encoders can be different from the desired distance before the distance correction function activates
int CorrectionSpeed = 3;                                      // sets the speed the the distcorrect function uses for each wheel
float oscf = 2;                                               // sets an overshoot correction factor which reduces any movement by this many CM's

// Other Global Variables
float Last_Distance_1 = 0;                                    // The most recent Wheel 1 travel distance variable used for the 'correction' function, updated in the movement function, set as a global variable so it can be called across functions
float Last_Distance_2 = 0;                                    // The most recent Wheel 2 travel distance variable used for the 'correction' function, updated in the movement function

// Prototype Functions
void movement (int SpeedValue, int TurnValue, float Distance_1_CM, float Distance_2_CM, int Acceleration = DefaultAcceleration, boolean VariableSpeed = true);          // sets the default inputs for the movement function so that specifically 'VariableSpeed' is set to 'true'
                                                                                                                                // when 'movement' is called in the loop before it is defined

// Main code
void setup(){
  pinMode(LEDPin, OUTPUT);                                    // Sets pin 3 to output for LED
  pinMode(buttonPin, INPUT);                                  // Sets pin 4 to input for start button

  myservo.attach(9);                                          // attaches the servo on pin 9 to the servo object
  myservo.write(2);                                           // Start position set to 2 degrees
  
  Wire.begin();                                               // Begin I2C bus
  Serial.begin(9600);                                         // Begin serial
  delay(100);                                                 // Wait for everything to power up

  Wire.beginTransmission(MD25ADDRESS);                        // Set MD25 operation MODE
  Wire.write(MODE_SELECTOR);
  Wire.write(Mode);                                           
  Wire.endTransmission();

  encodeReset();                                              // Calls a function that resets the encoder values to 0 
}


// Path
void loop(){

  start();                                                    // Wait for a button push before continuing loop
  
  delay(1000);

  encodeReset();                                              // Reset encoder values to 0
  
  //Serial.println("Start - 1");
  movement(S, 0, 100, 100);                                     // Calls a function that moves the platform with a combined speed, turning speed, and distances for each motor in cm, forward 34cm
  DistCorrection();                                           // calls a function to correct for any under/over movement due to momentum or other causes

  //Serial.println(" 1");
  movement(0, TurnMulti*S, ((WheelBaseDiameter/2) * pi * (90.0/180)), -((WheelBaseDiameter/2) * pi * (90.0/180)));                                   // 90 degree clockwise turn 
  DistCorrection();

  //Serial.println("1 - 2");
  movement(S, 0, 26, 26);                                   // forward 26cm    
  DistCorrection();                                           // calls a function to correct for any under/over movement due to momentum or other causes
  
  //Serial.println("2");
  movement(0, -TurnMulti*S, -((WheelBaseDiameter/2) * pi * (91.0/180)), ((WheelBaseDiameter/2) * pi * (91.0/180)));                                   // 90 degree anticlockwise turn 
  DistCorrection();

  //Serial.println("2 - 3");
  movement(S, 0, 50, 50);                                   // forward 26cm  
  DistCorrection();                                           // calls a function to correct for any under/over movement due to momentum or other causes

  //Serial.println("3");
  movement(0, -TurnMulti*S, -((WheelBaseDiameter/2) * pi * (90.0/180)), ((WheelBaseDiameter/2) * pi * (90.0/180)));                                   // 90 degree anticlockwise turn  
  DistCorrection();

  //Serial.println("3 - 4");
  movement(0.8*ArcMulti*26, 0.9*ArcMulti*WheelBaseDiameter/2, ((pi/2)*(26 + (WheelBaseDiameter/2))), (((pi/2)*(26 - (WheelBaseDiameter/2)))));                                   // 90 degree clockwise arc radius 26cm  
  DistCorrection();                                           // calls a function to correct for any under/over movement due to momentum or other causes
  
  //Serial.println("4");
  movement(0, TurnMulti*S, ((WheelBaseDiameter/2) * pi * (94.0/180)), -((WheelBaseDiameter/2) * pi * (94.0/180)));                                   // 90 degree clockwise turn, 2 degree fudge factor
  DistCorrection();

  //Serial.println("4 - 5");
  movement(S, 0, 66, 66);                                   // forward 66cm                       
  DistCorrection();                                           // calls a function to correct for any under/over movement due to momentum or other causes

  exit(0);
}


void start(){
  if (digitalRead(buttonPin) == LOW){
    LEDflash();
    LEDflash();
    }
  else {start();}
}


void movement (int SpeedValue, int TurnValue, float Distance_1_CM, float Distance_2_CM, int Acceleration, boolean VariableSpeed){                                               // This function moves the platform with a set speed and turn value for each wheel until they have moved the defined distance set in cm
                                                                                                                                                              // If VariableSpeed is true (default) then the encoders will slow as a proportion of the distance moved, otherwise speed is constant

  int Speed = 0;                                                         // Creates a speed variable (SPEED1)
  int Turn = 0;                                                          // Creates a turn variable (SPEED2)
  float e1 = encoder1();                                                 // Calls a function that reads value of encoder 1
  float e2 = encoder2();                                                 // Calls a function that reads value of encoder 2
  Last_Distance_1 = Distance_1_CM;                                       // Sets the distance for wheel 1 as a global variable so it can be used by the DistCorrection function
  Last_Distance_2 = Distance_2_CM;                                       // Sets the distance for wheel 2 as a global variable so it can be used by the DistCorrection function

    while(abs(e1) < abs(Distance_1_CM)-oscf && abs(e2) < abs(Distance_2_CM)-oscf){     // If statement to check the status of the traveled distance, absolutes used incase the motors are in reverse

    e1 = encoder1();                                                     // Updates encoder 1 reading
    e2 = encoder2();                                                     // Updates encoder 2 reading
    if(VariableSpeed == true && (e1/Distance_1_CM) > 0.5){                                           // Checks whether speed needs to be varibale or constant
      Speed = (1-(1-(FinalSpeed/S))*(e1/Distance_1_CM))*SpeedValue;                       // Multiplies the SpeedValue so it starts at 100% speed at the start of the movement, after 50% of the movement it decreases linearly and ends at speed 10
      Turn = (1-(1-(FinalSpeed/S))*(e1/Distance_1_CM))*TurnValue;                         // Multiplies the TurnValue so it starts at 100% speed at the start of the movement, after 50% of the movement it decreases linearly and ends at speed 10
    }
    else{
      Speed = SpeedValue;                                                // Leaves SpeedValue unchanged
      Turn = TurnValue;                                                  // Leaves TurnValue unchanged
    }
    
    Wire.beginTransmission(MD25ADDRESS);                      // Sets the acceleration to register 1
    Wire.write(ACCELERATION);
    Wire.write(Acceleration);
    Wire.endTransmission();

    Wire.beginTransmission(MD25ADDRESS);                      // Sets a combined motor speed value
    Wire.write(SPEED1);
    Wire.write(Speed);
    Wire.endTransmission();
    
    Wire.beginTransmission(MD25ADDRESS);                      //Sets a turning motor speed value
    Wire.write(SPEED2);
    Wire.write(Turn);
    Wire.endTransmission();

    e1 = encoder1();                                          // Updates encoder 1 reading
    e2 = encoder2();                                          // Updates encoder 2 reading

    Serial.print("e1 \t");
    Serial.print(e1);
    Serial.print("\t e2 \t");
    Serial.println(e2);
    }
  stopMotor();                                                // Stops the power to the encoders
  Serial.println("end");
  Serial.print("D1 \t");
  Serial.print(Distance_1_CM);
  Serial.print("\t D2 \t");
  Serial.println(Distance_2_CM);
}


void DistCorrection(){                                        // Corrects any over/undermovement due to momentum, corrects each wheel independantly to do both distance and angle.
  float e1 = encoder1();                                      // Calls a function that reads value of encoder 1
  float e2 = encoder2();                                      // Calls a function that reads value of encoder 2
    Serial.print("e1 \t");
    Serial.print(e1);
    Serial.print("\t e2 \t");
    Serial.println(e2);
  float D1 = (Last_Distance_1 - e1);                          // calculates difference between the encoder distance and the desired distance for wheel 1
  int Sign1 = D1/abs(D1);                                     // calulates the sign of D1 to determine whether the robot under or over moved
  float D2 = (Last_Distance_2 - e2);                          // calculates difference between the encoder distance and the desired distance for wheel 2
  int Sign2 = D2/abs(D2);                                     // calulates the sign of D2 to determine whether the robot under or over moved
  encodeReset();

  //if (abs(D1) >= limit){                                                     // Only corrects if the difference is larger enough as it will overcorrect if the distance is small
    movement((CorrectionSpeed * Sign1), CorrectionSpeed, abs(D1)+oscf, 10000, 1, false);            // Corrects wheel 1 so the encoder reads what it should, distance 2 is arbitrary but needs to be high so it does not stop the movement function before wheel 1 has adjusted
  //}
  
  //if (abs(D2) >= limit){                                                     // Only corrects if the difference is larger enough as it will overcorrect if the distance is small
    movement((CorrectionSpeed * Sign2), -CorrectionSpeed, 10000, abs(D2)+oscf, 1, false);           // Corrects wheel 2 so the encoder reads what it should, distance 1 is arbitrary but needs to be high so it does not stop the movement function before wheel 2 has adjusted
  //}
  encodeReset();                                                                       // Resets the encoders to 0
}


void LEDflash(){
  digitalWrite(LEDPin, HIGH);                               // Sets the output pin for the LED to high
  delay(50);                                               // Holds LED high for a set time in ms
  digitalWrite(LEDPin, LOW);                                // sets the output pin the the LED to low
}


void encodeReset(){                                         // This function resets the encoder values to 0
  Wire.beginTransmission(MD25ADDRESS);
  Wire.write(CMD);
  Wire.write(0x20);                                         
  Wire.endTransmission(); 
  delay(50);
}


float encoder1(){                                           // Function to read and display value of encoder 1 as a long
  Wire.beginTransmission(MD25ADDRESS);                      // Send byte to get a reading from encoder 1
  Wire.write(ENCODERONE);
  Wire.endTransmission();

  Wire.requestFrom(MD25ADDRESS, 4);                         // Request 4 bytes from MD25
  while(Wire.available() < 4);                              // Wait for 4 bytes to arrive
  long poss1 = Wire.read();                                 // First byte for encoder 1, HH.
  poss1 <<= 8;
  poss1 += Wire.read();                                     // Second byte for encoder 1, HL
  poss1 <<= 8;
  poss1 += Wire.read();                                     // Third byte for encoder 1, LH
  poss1 <<= 8;
  poss1  +=Wire.read();                                     // Fourth byte for encoder 1, LLalue
  delay(5);                                                 // Wait for everything to make sure everything is sent
  return(poss1*(WheelDiameter*pi/360));                     // Convert encoder value to cm using wheel diameter
}


float encoder2(){                                            // Function to read and display velue of encoder 2 as a long
  Wire.beginTransmission(MD25ADDRESS);           
  Wire.write(ENCODERTWO);
  Wire.endTransmission();

  Wire.requestFrom(MD25ADDRESS, 4);                         // Request 4 bytes from MD25
  while(Wire.available() < 4);                              // Wait for 4 bytes to become available
  long poss2 = Wire.read();                                 // First byte for encoder 2, HH
  poss2 <<= 8;
  poss2 += Wire.read();                                     // Second byte for encoder 2, HL             
  poss2 <<= 8;
  poss2 += Wire.read();                                     // Third byte for encoder 2, LH             
  poss2 <<= 8;
  poss2  +=Wire.read();                                     // Fourth byte for encoder 2, LLalue
  delay(5);                                                 // Wait to make sure everything is sent
  return(poss2*(WheelDiameter*pi/360));                     // Convert encoder value to cm using wheel diameter
}


void stopMotor(){                                           // Function to stop motors
  
  Wire.beginTransmission(MD25ADDRESS);                      // Sets the acceleration to register 10 (0.65s)
  Wire.write(ACCELERATION);
  Wire.write(7);
  Wire.endTransmission();

  Wire.beginTransmission(MD25ADDRESS);                      // Stops motors motor 1 if operated in MODE 0 or 1 and Stops both motors if operated in MODE 2 or 3
  Wire.write(SPEED1);
  Wire.write(0);
  Wire.endTransmission();

  Wire.beginTransmission(MD25ADDRESS);                      // Stops motors motor 2 when operated in MODE 0 or 1 and Stops both motors while in turning sequence if operated in MODE 2 or 3
  Wire.write(SPEED2);
  Wire.write(0);
  Wire.endTransmission();
  delay(200);

  encoder1();                                                // Calls a function that reads value of encoder 1
  encoder2();                                                // Calls a function that reads value of encoder 2
}  
